anticolon/BedsideClock/bedside_clock_promo.jpg

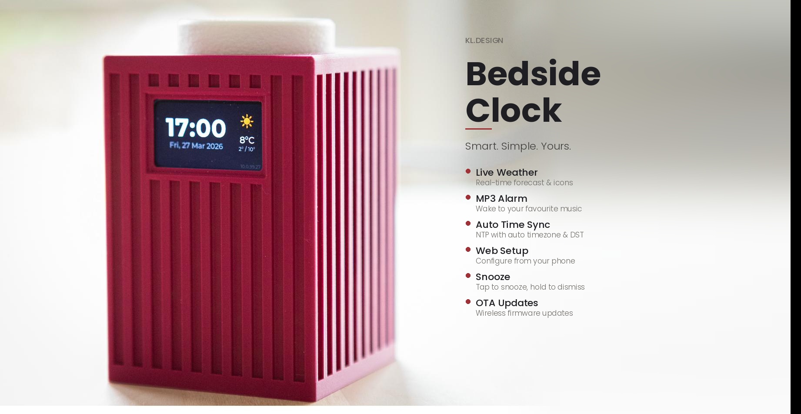
bedside_clock_promo.jpg
