anticolon/BedsideClock/BedsideClock/BedsideClock.ino

/********************************************************************
  Bedside Clock — ESP32-C6 + Waveshare 1.47" LCD (320x172)
  ST7789 + Arduino_GFX + LVGL 8.4.0

  MIT License

  Copyright (c) 2025 KL.Design

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
  Features:
    - Big centered clock on left 3/4, weather on right 1/4
    - Rich Meteocons weather icons + temperature
    - NTP time with auto-timezone from coordinates
    - Open-Meteo weather API (free, no key needed)
    - Day/night icon variants
    - Web-based location setup (country -> city search)
    - Alarm with MP3 playback from SD card (MAX98357 I2S amp)
    - Snooze with configurable duration
    - Rotary encoder menu for on-screen settings
    - MP3 file upload/delete via web interface
    - Inspirational wake-up messages
    - Captive Portal WiFi setup (OPEN AP)
    - OTA firmware update
    - BOOT hold (GPIO9) to force AP mode
    - Web interface enable/disable for security

  REQUIRED FILES (same folder as this .ino):
    - lv_conf.h
    - lv_font_clock_big.c  (generated by LVGL font converter)
    - weather_icons.h
    - icon_*.c files        (generated by LVGL image converter)

  REQUIRED LIBRARIES:
    - ESP8266Audio (for AudioFileSourceSD, AudioGeneratorMP3, AudioOutputI2S)
    - SD

  Pins (factory wired):
    LCD: DC=15, CS=14, SCK=7, MOSI=6, RST=21, BLK=22
    SD:  SCK=7(shared), MOSI=6(shared), MISO=5, CS=4
    I2S: BCLK=2, LRC=3, DIN=1
    Encoder: CLK=18, DT=23, SW=0

  KL.Design

  Third-party assets:

  Meteocons Weather Icons — Copyright (c) Bas Milius
  Licensed under the MIT License
  https://github.com/basmilius/weather-icons

  Montserrat Font — Copyright (c) Julieta Ulanovsky, Sol Matas,
  Juan Pablo del Peral, Jacques Le Bailly
  Licensed under the SIL Open Font License 1.1
  https://scripts.sil.org/OFL
  Used via LVGL built-in fonts and custom clock font generation.
********************************************************************/

#define FW_VERSION "1.2.0"

#include <Arduino.h>
#include <SPI.h>
#include <WiFi.h>
#include <Preferences.h>
#include <HTTPClient.h>
#include <time.h>

#include <AsyncTCP.h>
#include <ESPAsyncWebServer.h>
#include <DNSServer.h>
#include <Update.h>
#include <esp_ota_ops.h>

#include <Arduino_GFX_Library.h>

#define LV_CONF_INCLUDE_SIMPLE
#include <lvgl.h>

// SD card
#include <SD.h>

// Audio (ESP8266Audio library)
#include <AudioFileSourceSD.h>
#include <AudioFileSourceBuffer.h>
#include <AudioGeneratorMP3.h>
#include <AudioOutputI2S.h>

#include "weather_icons.h"

// Custom 64px font for big clock digits
LV_FONT_DECLARE(lv_font_clock_big);

// ==========================================================================
//  In-memory log ring buffer (viewable at /log)
// ==========================================================================
#define LOG_BUF_SIZE 8192
static char logBuffer[LOG_BUF_SIZE];
static size_t logPos = 0;
static bool logWrapped = false;
static portMUX_TYPE logMux = portMUX_INITIALIZER_UNLOCKED;  // logMsg() is called from loop() and AsyncTCP

void logMsg(const char *fmt, ...) __attribute__((format(printf, 1, 2)));  // compiler checks format strings
void logMsg(const char *fmt, ...) {
  char tmp[256];
  va_list args;
  va_start(args, fmt);
  int n = vsnprintf(tmp, sizeof(tmp), fmt, args);
  va_end(args);
  if (n <= 0) return;
  if (n >= (int)sizeof(tmp)) n = sizeof(tmp) - 1;

  // Write to Serial
  Serial.print(tmp);

  // Write to ring buffer
  portENTER_CRITICAL(&logMux);
  for (int i = 0; i < n; i++) {
    logBuffer[logPos] = tmp[i];
    logPos++;
    if (logPos >= LOG_BUF_SIZE) {
      logPos = 0;
      logWrapped = true;
    }
  }
  portEXIT_CRITICAL(&logMux);
}

String getLog() {
  // Snapshot under the lock (no heap work inside the critical section)
  char *snap = (char *)malloc(LOG_BUF_SIZE + 1);
  if (!snap) return String("(out of memory)");
  size_t n = 0;
  portENTER_CRITICAL(&logMux);
  if (logWrapped) {
    memcpy(snap, logBuffer + logPos, LOG_BUF_SIZE - logPos);
    memcpy(snap + (LOG_BUF_SIZE - logPos), logBuffer, logPos);
    n = LOG_BUF_SIZE;
  } else {
    memcpy(snap, logBuffer, logPos);
    n = logPos;
  }
  portEXIT_CRITICAL(&logMux);
  snap[n] = 0;
  String out(snap);
  free(snap);
  return out;
}

void clearLog() {
  portENTER_CRITICAL(&logMux);
  logPos = 0;
  logWrapped = false;
  memset(logBuffer, 0, LOG_BUF_SIZE);
  portEXIT_CRITICAL(&logMux);
}

// ==========================================================================
//  DEFAULTS (used if nothing saved in Preferences)
// ==========================================================================
#define DEFAULT_LAT       59.33
#define DEFAULT_LON       18.07
#define DEFAULT_TZ_NAME   "Europe/Stockholm"
#define NTP_SERVER        "pool.ntp.org"
#define WEATHER_INTERVAL_MS  (15UL * 60 * 1000)  // 15 minutes

// ==========================================================================
//  PINS
// ==========================================================================
#define LCD_DC    15
#define LCD_CS    14
#define LCD_SCK    7
#define LCD_MOSI   6
#define LCD_RST   21
#define LCD_BL    22
#define BOOT_BTN_PIN  9

// SD card (shares SPI bus with LCD)
#define SD_MISO    5
#define SD_CS      4

// I2S audio (MAX98357)
#define I2S_BCLK   2
#define I2S_LRC    3
#define I2S_DOUT   1

// Rotary encoder (EC11) — also used as alarm dismiss (tap) and menu (hold 1s)
#define ENC_CLK    18   // A pin
#define ENC_DT     23   // B pin
#define ENC_SW      0   // Push switch (active LOW)

#define MENU_HOLD_MS  1000   // hold encoder button to enter/exit menu

#define FORCE_PORTAL_HOLD_MS  5000   // matches README; long enough to avoid accidental reboots

// ==========================================================================
//  DISPLAY  (landscape 320×172)
// ==========================================================================
Arduino_DataBus *bus = new Arduino_ESP32SPI(LCD_DC, LCD_CS, LCD_SCK, LCD_MOSI);
Arduino_GFX *gfx = new Arduino_ST7789(
  bus, LCD_RST,
  1,          // rotation = 1 (landscape 320×172)
  true,       // IPS = true (correct color inversion for Waveshare 1.47")
  172, 320,   // native W × H
  34, 0,      // col_offset1, row_offset1
  34, 0       // col_offset2, row_offset2
);

// ==========================================================================
//  LVGL buffers & pointers
// ==========================================================================
static lv_disp_draw_buf_t draw_buf;
static lv_color_t *disp_draw_buf = nullptr;

// Portal UI
static lv_obj_t *label_status   = NULL;
static lv_obj_t *label_ip       = NULL;
static lv_obj_t *boot_bar       = NULL;
static lv_obj_t *boot_bar_label = NULL;

// Clock UI
static lv_obj_t *label_time     = NULL;
static lv_obj_t *label_date     = NULL;
static lv_obj_t *label_temp     = NULL;
static lv_obj_t *label_hilo        = NULL;   // daily high/low
static lv_obj_t *label_alarm    = NULL;   // alarm indicator
static lv_obj_t *weather_icon_img = NULL;

// ==========================================================================
//  WiFi / Web / DNS
// ==========================================================================
Preferences prefs;
AsyncWebServer server(80);
bool webEnabled = true;  // web config interface on/off
DNSServer dnsServer;

bool captivePortalRunning = false;
bool portalForced = false;   // portal opened on purpose (BOOT hold) — never auto-leave it

#define WIFI_CONNECT_TIMEOUT_MS  20000                 // boot-time connect attempt
#define PORTAL_WIFI_RETRY_MS     (2UL * 60 * 1000)     // fallback portal: retry saved WiFi this often
#define WIFI_KEEPALIVE_MS        60000                 // clock mode: reconnect check interval
bool clockMode = false;
String savedSSID, savedPASS, scannedOptionsHTML;

// ==========================================================================
//  SD Card
// ==========================================================================
bool sdCardOk = false;
String mp3Files[32];       // up to 32 MP3 files
int mp3FileCount = 0;

// ==========================================================================
//  Audio
// ==========================================================================
AudioGeneratorMP3 *mp3Player = nullptr;
AudioFileSourceSD *mp3Source = nullptr;
AudioFileSourceBuffer *mp3Buffer = nullptr;
AudioOutputI2S    *audioOut  = nullptr;
bool audioPlaying = false;
bool testPlaying = false;     // test playback (non-alarm)

// Audio command flags — set by async web handlers, acted on by main loop
volatile bool audioReqTestStart = false;
volatile bool audioReqTestStop  = false;
volatile bool audioReqDismiss   = false;
volatile bool audioReqVolume    = false;  // apply volume change from main loop
volatile bool uiReqAlarmLabel   = false;  // request alarm label refresh from main loop
volatile bool uploadInProgress  = false;  // true while receiving file upload chunks
volatile uint32_t uploadLastActivity = 0; // millis() of last upload body callback (idle watchdog)
volatile bool reqRescanMP3      = false;  // request MP3 list rescan from main loop
volatile bool reqLocationApply  = false;  // apply new location (TZ + weather) from main loop

// ==========================================================================
//  Alarm settings (saved in Preferences)
// ==========================================================================
int    alarmHour   = 7;
int    alarmMinute = 0;
bool   alarmEnabled = false;   // armed for next trigger
String alarmSound  = "";       // MP3 filename on SD
int    alarmVolume = 50;       // 0-100 percentage
bool   alarmFiring = false;    // currently ringing
bool   alarmSnoozing = false; // snooze countdown active
unsigned long snoozeEndTime = 0;
int    snoozeDuration = 5;    // snooze minutes (saved in prefs)
time_t lastFiredTarget = 0;   // alarm moment that last rang (or was skipped), so it rings once
String firingSound = "";       // tune picked when the alarm fired (snooze re-rings the same one)
String playingFile = "";       // MP3 currently open (alarm or test)

// Weekly schedule (advanced, opt-in). While on, it replaces the single
// one-shot alarm: each active day rings every week. Index = tm_wday (0 = Sunday).
struct SchedDay { uint8_t on, hour, min; };
bool     schedEnabled = false;
bool     schedStored  = false;   // schedule saved at least once (else seeded from the alarm)
SchedDay sched[7];
String   schedSound[7];          // "" = use the default tune (alarmSound)
time_t   skipTarget = 0;         // scheduled alarm moment the user chose to skip (0 = none)
const char *const dayNames[7] = { "Sun", "Mon", "Tue", "Wed", "Thu", "Fri", "Sat" };

// Alarm wake-up messages (random pick on fire)
const char* alarmMessages[] = {
  "Have a wonderful day!",
  "This day is full of potential!",
  "Dad loves you!",
  "Mom loves you!",
  "You are beautiful!",
  "You make the world brighter!",
  "Today is going to be amazing!",
  "You are so loved!",
  "The world needs your smile!",
  "You are stronger than you know!",
  "Great things await you today!",
  "You are enough, always!",
  "Today is yours to shine!",
  "Be proud of who you are!",
  "Your family believes in you!"
};
#define NUM_ALARM_MESSAGES (sizeof(alarmMessages) / sizeof(alarmMessages[0]))
const char* currentAlarmMsg = alarmMessages[0];

// ==========================================================================
//  Rotary Encoder state (ISR-driven full quadrature decode)
// ==========================================================================
volatile int encDelta = 0;          // accumulated rotation (+/- ticks)
static bool encSwPressed = false;
static bool encSwHandled = false;   // prevent repeat actions
static uint32_t encSwDownTime = 0;
static bool encLongHandled = false; // long-press already acted on

// Full quadrature state table — maps (prevState << 2 | newState) to direction.
// 0 = no move or invalid, +1 = CW, -1 = CCW
static const int8_t encTable[16] = {
   0, -1,  1,  0,
   1,  0,  0, -1,
  -1,  0,  0,  1,
   0,  1, -1,  0
};
static volatile uint8_t encState = 0;  // last 2-bit gray code state

void IRAM_ATTR encoderISR() {
  uint8_t s = encState & 3;  // previous state
  if (digitalRead(ENC_CLK)) s |= 4;
  if (digitalRead(ENC_DT))  s |= 8;
  encState = (s >> 2);       // save new state for next time
  encDelta += encTable[s];
}

// ==========================================================================
//  On-screen Menu state
// ==========================================================================
bool menuActive = false;
int  menuCursor = 0;          // 0=Back, 1=Brightness, 2=AlarmTime, 3=AlarmSound, 4=AlarmArm
bool menuEditing = false;     // currently editing a value
int  menuEditSub = 0;         // sub-field: 0=hour, 1=minute for alarm time

#define MENU_ITEMS 8
const char* menuLabels[] = { "Brightness", "Wake up", "Alarm", "Snooze", "Tune", "Volume", "Test", "Webpage" };

// Menu LVGL objects
static lv_obj_t *menuContainer = NULL;
static lv_obj_t *menuItemLabels[MENU_ITEMS] = {};
static lv_obj_t *menuValueLabels[MENU_ITEMS] = {};

// ==========================================================================
//  Location settings (saved in Preferences)
// ==========================================================================
float  cfgLat = DEFAULT_LAT;
float  cfgLon = DEFAULT_LON;
String cfgTzName = DEFAULT_TZ_NAME;
String cfgCity = "Stockholm";
String cfgCountry = "Sweden";
int    cfgUtcOffset = 3600;    // seconds, fetched from Open-Meteo
int    cfgBrightness = 255;   // 0-255 backlight PWM

// ==========================================================================
//  Weather data
// ==========================================================================
int   weatherCode    = -1;
float weatherTemp    = 0.0;
float weatherTempMin = 0.0;
float weatherTempMax = 0.0;
bool  weatherIsDay   = true;
bool  weatherValid   = false;
unsigned long lastWeatherFetch = 0;

// ==========================================================================
//  WMO Weather Code descriptions
// ==========================================================================
const char* wmoDescription(int code) {
  switch (code) {
    case 0:  return "Clear";
    case 1:  return "Mostly Clear";
    case 2:  return "Partly Cloudy";
    case 3:  return "Overcast";
    case 45: case 48: return "Foggy";
    case 51: case 53: case 55: return "Drizzle";
    case 56: case 57: return "Freezing Drizzle";
    case 61: return "Light Rain";
    case 63: return "Rain";
    case 65: return "Heavy Rain";
    case 66: case 67: return "Freezing Rain";
    case 71: return "Light Snow";
    case 73: return "Snow";
    case 75: return "Heavy Snow";
    case 77: return "Snow Grains";
    case 80: case 81: case 82: return "Showers";
    case 85: case 86: return "Snow Showers";
    case 95: return "Thunderstorm";
    case 96: case 99: return "Thunderstorm+Hail";
    default: return "Unknown";
  }
}

// ==========================================================================
//  Preferences load/save
// ==========================================================================
void loadSavedWiFi() {
  prefs.begin("wifi", true);
  savedSSID = prefs.getString("ssid", "");
  savedPASS = prefs.getString("pass", "");
  prefs.end();
}
void clearWiFiCredentials() {
  prefs.begin("wifi", false);
  prefs.remove("ssid"); prefs.remove("pass");
  prefs.end();
}
// Pages before v1.2.0 had no charset, so browsers posted city names with
// a-umlaut etc. as Windows-1252/Latin-1 bytes. Pages are UTF-8 now: convert once.
// Returns true if s was changed.
bool latin1ToUtf8(String &s) {
  const uint8_t *p = (const uint8_t *)s.c_str();
  bool valid = true;
  for (int i = 0; p[i] && valid; ) {
    int n = p[i] < 0x80 ? 0 : (p[i] & 0xE0) == 0xC0 ? 1 : (p[i] & 0xF0) == 0xE0 ? 2 : (p[i] & 0xF8) == 0xF0 ? 3 : -1;
    if (n < 0 || (n == 1 && p[i] < 0xC2)) { valid = false; break; }
    for (int k = 1; k <= n && valid; k++) if ((p[i + k] & 0xC0) != 0x80) valid = false;  // stops at the NUL
    if (valid) i += n + 1;
  }
  if (valid) return false;
  String out;
  out.reserve(s.length() * 2);
  for (int i = 0; p[i]; i++) {
    if (p[i] < 0x80) out += (char)p[i];
    else { out += (char)(0xC0 | (p[i] >> 6)); out += (char)(0x80 | (p[i] & 0x3F)); }
  }
  s = out;
  return true;
}

void saveLocationSettings();
void loadLocationSettings() {
  prefs.begin("loc", true);
  cfgLat     = prefs.getFloat("lat", DEFAULT_LAT);
  cfgLon     = prefs.getFloat("lon", DEFAULT_LON);
  cfgTzName  = prefs.getString("tz", DEFAULT_TZ_NAME);
  cfgCity    = prefs.getString("city", "Stockholm");
  cfgCountry = prefs.getString("country", "Sweden");
  cfgUtcOffset = prefs.getInt("utcoff", 3600);
  cfgBrightness = prefs.getInt("bright", 255);
  webEnabled = prefs.getBool("webOn", true);
  prefs.end();
  bool fixed = latin1ToUtf8(cfgCity);
  fixed |= latin1ToUtf8(cfgCountry);
  if (fixed) {
    saveLocationSettings();
    logMsg("Location name converted to UTF-8\n");
  }
}
void saveLocationSettings() {
  prefs.begin("loc", false);
  prefs.putFloat("lat", cfgLat);
  prefs.putFloat("lon", cfgLon);
  prefs.putString("tz", cfgTzName);
  prefs.putString("city", cfgCity);
  prefs.putString("country", cfgCountry);
  prefs.putInt("utcoff", cfgUtcOffset);
  prefs.putInt("bright", cfgBrightness);
  prefs.putBool("webOn", webEnabled);
  prefs.end();
}

// ==========================================================================
//  OTA safety net — automatic rollback after a crash loop
// ==========================================================================
// The bootloader has no rollback support, so the app does it itself. Every
// boot caused by a crash or watchdog bumps a counter in NVS; a normal boot, or
// BOOT_HEALTHY_MS of uptime, resets it. After BOOT_CRASH_LIMIT crash boots in a
// row we switch the boot partition to the other OTA slot — the firmware that
// ran before the last OTA update — so a bad update can't brick the clock.
#define BOOT_CRASH_LIMIT  3
#define BOOT_HEALTHY_MS   (90UL * 1000)

void bootGuardCheck()
{
  esp_reset_reason_t why = esp_reset_reason();
  bool crashed = (why == ESP_RST_PANIC || why == ESP_RST_INT_WDT ||
                  why == ESP_RST_TASK_WDT || why == ESP_RST_WDT);
  prefs.begin("boot", false);
  int crashes = crashed ? prefs.getInt("crashes", 0) + 1 : 0;
  prefs.putInt("crashes", crashes);
  prefs.end();

  const esp_partition_t *running = esp_ota_get_running_partition();
  logMsg("Boot: v%s from %s, reset reason %d, crash boots in a row: %d\n",
         FW_VERSION, running ? running->label : "?", (int)why, crashes);
  if (crashes < BOOT_CRASH_LIMIT) return;

  prefs.begin("boot", false);
  prefs.putInt("crashes", 0);
  prefs.end();

  const esp_partition_t *other = esp_ota_get_next_update_partition(NULL);
  esp_app_desc_t desc;
  if (other && other != running &&
      esp_ota_get_partition_description(other, &desc) == ESP_OK &&
      esp_ota_set_boot_partition(other) == ESP_OK) {
    logMsg("Crash loop: rolling back to %s\n", other->label);
    delay(100);
    esp_restart();
  }
  logMsg("Crash loop, but no valid firmware in the other slot\n");
}

// Called from loop(): once we've stayed up long enough, this firmware is good.
void bootGuardMarkHealthy()
{
  static bool done = false;
  if (done || millis() < BOOT_HEALTHY_MS) return;
  done = true;
  prefs.begin("boot", false);
  if (prefs.getInt("crashes", 0) != 0) prefs.putInt("crashes", 0);
  prefs.end();
}

// ==========================================================================
//  Apply timezone from stored settings
// ==========================================================================
void applyTimezone() {
  // Use POSIX TZ string: we set a simple UTC offset.
  // For full DST support we'd need the POSIX TZ rule, but using
  // Open-Meteo's utc_offset_seconds handles DST at fetch time.
  // We re-sync NTP periodically so the offset stays current.
  configTime(cfgUtcOffset, 0, NTP_SERVER);
  logMsg("Timezone applied: UTC%+d (%s)\n", cfgUtcOffset/3600, cfgTzName.c_str());
}

void applyBrightness() {
  analogWrite(LCD_BL, cfgBrightness);
  logMsg("Brightness: %d/255\n", cfgBrightness);
}

// ==========================================================================
//  Alarm preferences
// ==========================================================================
void loadAlarmSettings() {
  prefs.begin("alarm", true);
  alarmHour    = prefs.getInt("hour", 7);
  alarmMinute  = prefs.getInt("min", 0);
  alarmEnabled = prefs.getBool("enabled", false);
  alarmSound   = prefs.getString("sound", "");
  alarmVolume  = prefs.getInt("vol", 50);
  snoozeDuration = prefs.getInt("snooze", 5);
  schedEnabled = prefs.getBool("schedOn", false);
  schedStored  = prefs.getBytes("sched", sched, sizeof(sched)) == sizeof(sched);
  for (int d = 0; d < 7; d++) {
    if (!schedStored || sched[d].hour > 23 || sched[d].min > 59) sched[d] = { 0, (uint8_t)alarmHour, (uint8_t)alarmMinute };
    char key[6]; snprintf(key, sizeof(key), "snd%d", d);
    schedSound[d] = prefs.getString(key, "");
  }
  skipTarget = (time_t)prefs.getLong64("skip", 0);
  prefs.end();
}
void saveAlarmSettings() {
  prefs.begin("alarm", false);
  prefs.putInt("hour", alarmHour);
  prefs.putInt("min", alarmMinute);
  prefs.putBool("enabled", alarmEnabled);
  prefs.putString("sound", alarmSound);
  prefs.putInt("vol", alarmVolume);
  prefs.putInt("snooze", snoozeDuration);
  prefs.end();
}
void saveSchedule() {
  prefs.begin("alarm", false);
  prefs.putBool("schedOn", schedEnabled);
  prefs.putBytes("sched", sched, sizeof(sched));
  for (int d = 0; d < 7; d++) {
    char key[6]; snprintf(key, sizeof(key), "snd%d", d);
    prefs.putString(key, schedSound[d]);
  }
  prefs.putLong64("skip", (int64_t)skipTarget);
  prefs.end();
  schedStored = true;
}

// ==========================================================================
//  SD Card init & MP3 file scanner
// ==========================================================================
void rescanMP3Files() {
  mp3FileCount = 0;
  if (!sdCardOk) return;
  File root = SD.open("/");
  if (root) {
    File f = root.openNextFile();
    while (f && mp3FileCount < 32) {
      String name = String(f.name());
      if (!f.isDirectory() && (name.endsWith(".mp3") || name.endsWith(".MP3"))) {
        if (!name.startsWith("/")) name = "/" + name;
        mp3Files[mp3FileCount++] = name;
      }
      f = root.openNextFile();
    }
    root.close();
  }
  logMsg("Rescan: found %d MP3 files\n", mp3FileCount);

  // If no alarm sound is selected (or selected file was deleted), auto-select the first one
  if (mp3FileCount > 0 && (alarmSound.length() == 0 || !SD.exists(alarmSound.c_str()))) {
    alarmSound = mp3Files[0];
    saveAlarmSettings();
    logMsg("Auto-selected alarm sound: %s\n", alarmSound.c_str());
  }
}

void initSDCard() {
  SPI.begin(LCD_SCK, SD_MISO, LCD_MOSI, SD_CS);
  if (SD.begin(SD_CS)) {
    sdCardOk = true;
    logMsg("SD card mounted\n");
    rescanMP3Files();
  } else {
    sdCardOk = false;
    logMsg("SD card mount failed\n");
  }
}

// ==========================================================================
//  Forward declarations (needed for cross-references in audio/alarm code)
// ==========================================================================
void dismissAlarm();
void updateAlarmLabel();
String htmlAttrEscape(const String &s);

// ==========================================================================
//  Audio playback
// ==========================================================================
#define ALARM_MIN_VOLUME  10   // a ringing alarm is never quieter than this (%)

void applyVolume() {
  int v = alarmVolume;
  if (alarmFiring && v < ALARM_MIN_VOLUME) v = ALARM_MIN_VOLUME;
  if (audioOut) audioOut->SetGain((float)v / 100.0f);
}

// ==========================================================================
//  Fallback alarm tone — used when the MP3 can't be played (no SD card,
//  missing or broken file), so a ringing alarm is never silent.
//  Invariant: I2S is running iff (mp3Player is playing) or toneActive.
//  AudioOutputI2S::begin() asserts if the channel already exists, so the tone
//  only starts after stopAlarmSound() has released the MP3 player.
// ==========================================================================
#define TONE_RATE        16000   // samples/s
#define TONE_HALF_PERIOD 4       // samples → 2 kHz square wave
#define TONE_AMPLITUDE   12000
static bool     toneActive = false;
static uint32_t toneSample = 0;

void stopAlarmSound();

void stopFallbackTone() {
  if (!toneActive) return;
  audioOut->stop();
  toneActive = false;
  applyVolume();
}

void startFallbackTone() {
  if (toneActive || !audioOut) return;
  stopAlarmSound();  // releases any MP3 player (and its I2S channel)
  audioOut->SetChannels(2);
  audioOut->SetRate(TONE_RATE);
  int v = alarmVolume < 30 ? 30 : alarmVolume;
  audioOut->SetGain((float)v / 100.0f);
  if (!audioOut->begin()) return;
  toneActive = true;
  toneSample = 0;
  audioPlaying = true;
  logMsg("Alarm: MP3 unavailable, playing fallback tone\n");
}

// Feed the I2S DMA without blocking: "beep-beep" (120 ms on/off) once a second
void loopFallbackTone() {
  if (!toneActive) return;
  for (int n = 0; n < 1024; n++) {
    uint32_t ms = (toneSample % TONE_RATE) * 1000UL / TONE_RATE;  // position within the 1 s pattern
    bool on = (ms < 120) || (ms >= 240 && ms < 360);
    int16_t v = on ? (((toneSample / TONE_HALF_PERIOD) & 1) ? TONE_AMPLITUDE : -TONE_AMPLITUDE) : 0;
    int16_t smp[2] = { v, v };
    if (!audioOut->ConsumeSample(smp)) break;  // DMA full — continue next loop
    toneSample++;
  }
}

// Alarm MP3 that dies right after starting (corrupt file) → switch to the tone
static uint32_t alarmMp3StartedAt = 0;
static int      alarmMp3QuickEnds = 0;

void initAudio() {
  audioOut = new AudioOutputI2S();
  audioOut->SetPinout(I2S_BCLK, I2S_LRC, I2S_DOUT);
  applyVolume();
}

void startAlarmSound() {
  alarmMp3QuickEnds = 0;
  if (!sdCardOk || firingSound.length() == 0) { startFallbackTone(); return; }
  stopAlarmSound();
  applyVolume();
  playingFile = firingSound;
  mp3Source = new AudioFileSourceSD(playingFile.c_str());
  mp3Buffer = new AudioFileSourceBuffer(mp3Source, 2048);
  mp3Player = new AudioGeneratorMP3();
  if (mp3Player->begin(mp3Buffer, audioOut)) {
    audioPlaying = true;
    alarmMp3StartedAt = millis();
    logMsg("Alarm playing: %s\n", playingFile.c_str());
  } else {
    logMsg("Failed to start MP3\n");
    delete mp3Player; mp3Player = nullptr;
    delete mp3Buffer; mp3Buffer = nullptr;
    delete mp3Source; mp3Source = nullptr;
    startFallbackTone();
  }
}

void stopAlarmSound() {
  if (mp3Player) {
    if (mp3Player->isRunning()) mp3Player->stop();
    delete mp3Player; mp3Player = nullptr;
  }
  if (mp3Buffer) {
    delete mp3Buffer; mp3Buffer = nullptr;
  }
  if (mp3Source) {
    delete mp3Source; mp3Source = nullptr;
  }
  stopFallbackTone();
  audioPlaying = false;
  testPlaying = false;
}

void startTestSound() {
  if (!sdCardOk || alarmSound.length() == 0) return;
  stopAlarmSound();
  applyVolume();
  playingFile = alarmSound;
  mp3Source = new AudioFileSourceSD(playingFile.c_str());
  mp3Buffer = new AudioFileSourceBuffer(mp3Source, 2048);
  mp3Player = new AudioGeneratorMP3();
  if (mp3Player->begin(mp3Buffer, audioOut)) {
    audioPlaying = true;
    testPlaying = true;
    logMsg("Test playing: %s at %d%%\n", alarmSound.c_str(), alarmVolume);
  } else {
    logMsg("Failed to start test MP3\n");
    delete mp3Player; mp3Player = nullptr;
    delete mp3Buffer; mp3Buffer = nullptr;
    delete mp3Source; mp3Source = nullptr;
  }
}

void stopTestSound() {
  stopAlarmSound();
}

void loopAudio() {
  // First, process any commands queued by async web handlers
  if (audioReqTestStop) {
    audioReqTestStop = false;
    stopTestSound();
  }
  if (audioReqDismiss) {
    audioReqDismiss = false;
    dismissAlarm();
  }
  if (audioReqTestStart) {
    audioReqTestStart = false;
    startTestSound();
  }
  if (audioReqVolume) {
    audioReqVolume = false;
    applyVolume();
  }

  loopFallbackTone();

  if (mp3Player && mp3Player->isRunning()) {
    if (!mp3Player->loop()) {
      // MP3 ended — clean up
      mp3Player->stop();
      delete mp3Player; mp3Player = nullptr;
      delete mp3Buffer; mp3Buffer = nullptr;
      delete mp3Source; mp3Source = nullptr;
      if (alarmFiring) {
        // Restart loop for alarm — unless the file keeps ending immediately
        // (corrupt/unreadable), then fall back to the built-in tone
        if (millis() - alarmMp3StartedAt < 1500) alarmMp3QuickEnds++;
        else alarmMp3QuickEnds = 0;
        if (alarmMp3QuickEnds >= 3) {
          audioPlaying = false;
          startFallbackTone();
          return;
        }
        delay(50);  // brief pause before restarting
        mp3Source = new AudioFileSourceSD(playingFile.c_str());
        mp3Buffer = new AudioFileSourceBuffer(mp3Source, 2048);
        mp3Player = new AudioGeneratorMP3();
        if (mp3Player->begin(mp3Buffer, audioOut)) {
          alarmMp3StartedAt = millis();
          logMsg("Alarm MP3 looping...\n");
        } else {
          logMsg("Failed to restart alarm MP3\n");
          delete mp3Player; mp3Player = nullptr;
          delete mp3Buffer; mp3Buffer = nullptr;
          delete mp3Source; mp3Source = nullptr;
          audioPlaying = false;
          startFallbackTone();
        }
      } else {
        // Test or other — just stop
        audioPlaying = false;
        testPlaying = false;
      }
    }
  }
}

// ==========================================================================
//  Alarm check (called every loop iteration in clock mode)
// ==========================================================================
// Fires during the alarm minute, and also catches up if the alarm moment was
// passed since the previous check (loop paused by an upload or a long blocking
// call, or the clock jumped forward, e.g. DST), up to ALARM_CATCHUP_MIN late.
// No catch-up on the first check after boot.
#define ALARM_CATCHUP_MIN 60

// Alarm time for weekday wd (0 = Sunday); false if no alarm that day
bool alarmForDay(int wd, int &h, int &m) {
  if (!schedEnabled) { h = alarmHour; m = alarmMinute; return alarmEnabled; }
  h = sched[wd].hour; m = sched[wd].min;
  return sched[wd].on;
}

// Alarm moment on the date dayOffset days from `now` (negative = past), 0 if none
time_t alarmOnDay(const struct tm &now, int dayOffset, int *wdOut) {
  struct tm t = now;
  t.tm_mday += dayOffset;
  t.tm_hour = 12; t.tm_min = 0; t.tm_sec = 0; t.tm_isdst = -1;
  mktime(&t);  // normalise the date and get its weekday
  int h, m;
  if (!alarmForDay(t.tm_wday, h, m)) return 0;
  t.tm_hour = h; t.tm_min = m; t.tm_isdst = -1;
  if (wdOut) *wdOut = t.tm_wday;
  return mktime(&t);
}

// Next alarm moment after now, 0 if none. withSkipped = false passes over a skipped one.
time_t nextAlarm(bool withSkipped, int *wdOut) {
  struct tm ti;
  if (!getLocalTime(&ti, 0)) return 0;
  time_t now = mktime(&ti);
  for (int d = 0; d <= 7; d++) {
    time_t c = alarmOnDay(ti, d, wdOut);
    if (c > now && (withSkipped || c != skipTarget)) return c;
  }
  return 0;
}

// "Tue 06:30" for the next alarm that will ring, "--:--" if none
void nextAlarmStr(char *buf, int len) {
  int wd = 0;
  time_t t = nextAlarm(false, &wd);
  if (!t) { snprintf(buf, len, "--:--"); return; }
  struct tm lt; localtime_r(&t, &lt);
  snprintf(buf, len, "%s %02d:%02d", dayNames[wd], lt.tm_hour, lt.tm_min);
}

// A skip that no longer matches the next alarm (schedule edited) is dropped
void schedDropStaleSkip() {
  if (skipTarget && (!schedEnabled || nextAlarm(true, nullptr) != skipTarget)) skipTarget = 0;
}

void checkAlarm() {
  static time_t lastCheck = 0;

  struct tm ti;
  if (!getLocalTime(&ti, 0)) return;
  time_t now = mktime(&ti);
  time_t prev = lastCheck ? lastCheck : now;
  lastCheck = now;  // track even while disarmed, so arming never fires retroactively

  // Schedule label names the next alarm: refresh it once a minute (also after NTP sync)
  static time_t lastLabelMin = 0;
  if (schedEnabled && now / 60 != lastLabelMin && !alarmFiring && !alarmSnoozing) {
    lastLabelMin = now / 60;
    updateAlarmLabel();
  }

  if (alarmFiring || alarmSnoozing) return;

  // Most recent alarm moment: today's, or yesterday's (with yesterday's settings)
  int wd = 0;
  time_t target = 0;
  for (int d = 0; d >= -1 && !target; d--) {
    time_t c = alarmOnDay(ti, d, &wd);
    if (c && c <= now) target = c;
  }

  // A skip whose moment passed long ago (clock was off) is dropped
  if (skipTarget && now - skipTarget > ALARM_CATCHUP_MIN * 60) {
    skipTarget = 0;
    saveSchedule();
  }

  if (!target || target == lastFiredTarget) return;
  bool inAlarmMinute = (now - target < 60);
  bool passedSinceLastCheck = (target > prev && now - target <= ALARM_CATCHUP_MIN * 60);
  if (!inAlarmMinute && !passedSinceLastCheck) return;

  lastFiredTarget = target;
  if (schedEnabled && target == skipTarget) {
    skipTarget = 0;
    saveSchedule();
    updateAlarmLabel();
    logMsg("Alarm skipped (%s)\n", dayNames[wd]);
    return;
  }

  // Tune: the day's own song if it still exists, else the default tune
  firingSound = alarmSound;
  if (schedEnabled && schedSound[wd].length() && sdCardOk && SD.exists(schedSound[wd].c_str()))
    firingSound = schedSound[wd];

  alarmFiring = true;
  if (!schedEnabled) {
    alarmEnabled = false;  // one-shot: disable after firing
    saveAlarmSettings();
  }
  currentAlarmMsg = alarmMessages[random(NUM_ALARM_MESSAGES)];
  startAlarmSound();
  updateAlarmLabel();
  logMsg("ALARM TRIGGERED! (%s)\n", schedEnabled ? dayNames[wd] : "single");
}

void dismissAlarm() {
  if (!alarmFiring && !alarmSnoozing) return;
  alarmFiring = false;
  alarmSnoozing = false;
  snoozeEndTime = 0;
  stopAlarmSound();
  updateAlarmLabel();
  logMsg("Alarm dismissed\n");
}

void snoozeAlarm() {
  if (!alarmFiring) return;
  stopAlarmSound();
  alarmFiring = false;
  alarmSnoozing = true;
  snoozeEndTime = millis() + (unsigned long)snoozeDuration * 60UL * 1000UL;
  updateAlarmLabel();
  logMsg("Snoozing for %d minutes\n", snoozeDuration);
}

void checkSnooze() {
  if (!alarmSnoozing) return;
  if ((long)(millis() - snoozeEndTime) >= 0) {  // wrap-safe (millis() rolls over every ~49.7 days)
    // Snooze expired — alarm fires again
    alarmSnoozing = false;
    alarmFiring = true;
    startAlarmSound();
    updateAlarmLabel();
    logMsg("Snooze ended - alarm firing again!\n");
  }
}

void updateAlarmLabel() {
  if (!label_alarm || menuActive) return;  // menuClose() → showClockUI() refreshes it
  if (alarmFiring) {
    lv_label_set_text(label_alarm, currentAlarmMsg);
    lv_obj_set_style_text_color(label_alarm, lv_color_hex(0xFFCC44), 0);
    lv_obj_set_pos(label_alarm, 0, (gfx->height() / 2) + 34);  // quotes shifted up
    lv_obj_clear_flag(label_alarm, LV_OBJ_FLAG_HIDDEN);
  } else if (alarmSnoozing) {
    // Show countdown
    unsigned long remaining = 0;
    long left = (long)(snoozeEndTime - millis());  // wrap-safe
    if (left > 0) remaining = left;
    int secLeft = remaining / 1000;
    int m = secLeft / 60;
    int s = secLeft % 60;
    char buf[24];
    snprintf(buf, sizeof(buf), "Snooze: %d:%02d", m, s);
    lv_label_set_text(label_alarm, buf);
    lv_obj_set_style_text_color(label_alarm, lv_color_hex(0x7CCFFF), 0);
    lv_obj_set_pos(label_alarm, 0, (gfx->height() / 2) + 44);  // original position
    lv_obj_clear_flag(label_alarm, LV_OBJ_FLAG_HIDDEN);
  } else if (schedEnabled ? nextAlarm(false, nullptr) != 0 : alarmEnabled) {
    char buf[24];
    if (schedEnabled) {
      char nb[12]; nextAlarmStr(nb, sizeof(nb));
      snprintf(buf, sizeof(buf), "Alarm: %s", nb);
    } else {
      snprintf(buf, sizeof(buf), "Alarm: %02d:%02d", alarmHour, alarmMinute);
    }
    lv_label_set_text(label_alarm, buf);
    lv_obj_set_style_text_color(label_alarm, lv_color_hex(0xFF3333), 0);
    lv_obj_set_pos(label_alarm, 0, (gfx->height() / 2) + 44);  // original position
    lv_obj_clear_flag(label_alarm, LV_OBJ_FLAG_HIDDEN);
  } else {
    lv_obj_add_flag(label_alarm, LV_OBJ_FLAG_HIDDEN);
  }
}

// ==========================================================================
//  Rotary Encoder reading (rotation via ISR, button polled here)
// ==========================================================================
#define ENC_SW_DEBOUNCE_MS 20

void readEncoder() {
  // Button state (polled — no need for ISR on a slow human press).
  // Debounced: a new level only counts once it has been stable for
  // ENC_SW_DEBOUNCE_MS, so contact bounce can't produce double presses.
  static bool rawLevel = false;
  static uint32_t rawSince = 0;
  bool raw = (digitalRead(ENC_SW) == LOW);
  if (raw != rawLevel) {
    rawLevel = raw;
    rawSince = millis();
  }
  if (millis() - rawSince < ENC_SW_DEBOUNCE_MS) return;

  bool pressed = rawLevel;
  if (pressed && !encSwPressed) {
    encSwDownTime = millis();
    encSwHandled = false;
    encLongHandled = false;
  }
  encSwPressed = pressed;
}

// Consume rotation delta (returns whole detent clicks, resets remainder)
// Full quadrature decode gives 4 state changes per EC11 detent.
// We accumulate and only emit complete detents.
static int encAccum = 0;
#define ENC_COUNTS_PER_DETENT 4

int consumeEncoderDelta() {
  noInterrupts();
  int raw = encDelta;
  encDelta = 0;
  interrupts();
  encAccum += raw;
  int detents = encAccum / ENC_COUNTS_PER_DETENT;
  encAccum %= ENC_COUNTS_PER_DETENT;  // keep remainder
  return detents;
}

// Check for short press (returns true once on release after <1s hold)
bool encoderShortPress() {
  if (!encSwPressed && !encSwHandled && encSwDownTime > 0 && !encLongHandled) {
    encSwHandled = true;
    encSwDownTime = 0;
    return true;
  }
  return false;
}

// Check for long press (returns true once after 1s hold while still pressed)
bool encoderLongPress() {
  if (encSwPressed && !encLongHandled && encSwDownTime > 0) {
    if (millis() - encSwDownTime >= MENU_HOLD_MS) {
      encLongHandled = true;
      return true;
    }
  }
  return false;
}

// ==========================================================================
//  On-screen Menu system
// ==========================================================================
void menuGetValueStr(int item, char *buf, int bufLen) {
  switch (item) {
    case 0: { // Brightness
      int pct = cfgBrightness * 100 / 255;
      snprintf(buf, bufLen, "%d%%", pct);
    } break;
    case 1: // Wake up (schedule: next alarm, read-only)
      if (schedEnabled) nextAlarmStr(buf, bufLen);
      else snprintf(buf, bufLen, "%02d:%02d", alarmHour, alarmMinute);
      break;
    case 2: // Alarm (schedule: skip the next alarm)
      if (schedEnabled) snprintf(buf, bufLen, "%s", skipTarget ? "Skip" : (nextAlarm(true, nullptr) ? "On" : "Off"));
      else snprintf(buf, bufLen, "%s", alarmEnabled ? "On" : "Off");
      break;
    case 3: snprintf(buf, bufLen, "%d min", snoozeDuration); break; // Snooze
    case 4: { // Tune
      if (alarmSound.length() == 0) snprintf(buf, bufLen, "(none)");
      else {
        const char *s = alarmSound.c_str();
        if (s[0] == '/') s++;
        snprintf(buf, bufLen, "%s", s);
      }
    } break;
    case 5: snprintf(buf, bufLen, "%d%%", alarmVolume); break; // Volume
    case 6: snprintf(buf, bufLen, "%s", testPlaying ? "Stop" : "Play"); break; // Test
    case 7: snprintf(buf, bufLen, "%s", webEnabled ? "On" : "Off"); break; // Webpage
  }
}

void hideClockUI() {
  if (label_time) lv_obj_add_flag(label_time, LV_OBJ_FLAG_HIDDEN);
  if (label_date) lv_obj_add_flag(label_date, LV_OBJ_FLAG_HIDDEN);
  if (label_alarm) lv_obj_add_flag(label_alarm, LV_OBJ_FLAG_HIDDEN);
  if (label_temp) lv_obj_add_flag(label_temp, LV_OBJ_FLAG_HIDDEN);
  if (label_hilo) lv_obj_add_flag(label_hilo, LV_OBJ_FLAG_HIDDEN);
  if (weather_icon_img) lv_obj_add_flag(weather_icon_img, LV_OBJ_FLAG_HIDDEN);
  if (label_status) lv_obj_add_flag(label_status, LV_OBJ_FLAG_HIDDEN);
  if (boot_bar) lv_obj_add_flag(boot_bar, LV_OBJ_FLAG_HIDDEN);
  if (boot_bar_label) lv_obj_add_flag(boot_bar_label, LV_OBJ_FLAG_HIDDEN);
}

void showClockUI() {
  if (label_time) lv_obj_clear_flag(label_time, LV_OBJ_FLAG_HIDDEN);
  if (label_date) lv_obj_clear_flag(label_date, LV_OBJ_FLAG_HIDDEN);
  if (label_temp) lv_obj_clear_flag(label_temp, LV_OBJ_FLAG_HIDDEN);
  if (label_hilo) lv_obj_clear_flag(label_hilo, LV_OBJ_FLAG_HIDDEN);
  if (weather_icon_img) lv_obj_clear_flag(weather_icon_img, LV_OBJ_FLAG_HIDDEN);
  if (label_status) lv_obj_clear_flag(label_status, LV_OBJ_FLAG_HIDDEN);
  updateAlarmLabel();  // will show/hide based on alarm state
}

void buildMenuUI() {
  lv_obj_t *scr = lv_scr_act();

  // Hide clock elements so they don't bleed through
  hideClockUI();

  // Full-screen overlay
  menuContainer = lv_obj_create(scr);
  lv_obj_remove_style_all(menuContainer);
  lv_obj_set_size(menuContainer, gfx->width(), gfx->height());
  lv_obj_set_pos(menuContainer, 0, 0);
  lv_obj_set_style_bg_color(menuContainer, lv_color_black(), 0);
  lv_obj_set_style_bg_opa(menuContainer, LV_OPA_COVER, 0);
  lv_obj_clear_flag(menuContainer, LV_OBJ_FLAG_SCROLLABLE);

  // Layout: 6 rows × 22px = 132px, centered vertically in 172px
  int rowH = 20;
  int totalH = MENU_ITEMS * rowH;
  int yStart = (gfx->height() - totalH) / 2 - 8 + 5;
  int leftX = 12;
  int valX = 120;   // value column start (after longest label "Brightness:")
  int valW = gfx->width() - valX - 8;  // ~192px for values

  for (int i = 0; i < MENU_ITEMS; i++) {
    int y = yStart + i * rowH;

    // Label: "Name:"
    menuItemLabels[i] = lv_label_create(menuContainer);
    char lbl[32];
    snprintf(lbl, sizeof(lbl), "  %s:", menuLabels[i]);
    lv_label_set_text(menuItemLabels[i], lbl);
    lv_obj_set_style_text_font(menuItemLabels[i], &lv_font_montserrat_14, 0);
    lv_obj_set_style_text_color(menuItemLabels[i], lv_color_hex(0x888888), 0);
    lv_obj_set_pos(menuItemLabels[i], leftX, y);

    // Value
    menuValueLabels[i] = lv_label_create(menuContainer);
    char vBuf[32]; menuGetValueStr(i, vBuf, sizeof(vBuf));
    lv_label_set_text(menuValueLabels[i], vBuf);
    lv_obj_set_style_text_font(menuValueLabels[i], &lv_font_montserrat_14, 0);
    lv_obj_set_style_text_color(menuValueLabels[i], lv_color_white(), 0);
    lv_obj_set_style_text_align(menuValueLabels[i], LV_TEXT_ALIGN_RIGHT, 0);
    lv_obj_set_width(menuValueLabels[i], valW);
    lv_label_set_long_mode(menuValueLabels[i], LV_LABEL_LONG_DOT);
    lv_obj_set_pos(menuValueLabels[i], valX, y);
  }

  // Hint at bottom
  lv_obj_t *hint = lv_label_create(menuContainer);
  lv_label_set_text(hint, "Hold to exit");
  lv_obj_set_style_text_font(hint, &lv_font_montserrat_10, 0);
  lv_obj_set_style_text_color(hint, lv_color_hex(0x333333), 0);
  lv_obj_align(hint, LV_ALIGN_BOTTOM_MID, 0, -2);

  menuCursor = 0;
  menuEditing = false;
  menuEditSub = 0;
  updateMenuHighlight();
}

void destroyMenuUI() {
  if (menuContainer) {
    lv_obj_del(menuContainer);
    menuContainer = NULL;
  }
  for (int i = 0; i < MENU_ITEMS; i++) {
    menuItemLabels[i] = NULL;
    menuValueLabels[i] = NULL;
  }
}

void updateMenuHighlight() {
  for (int i = 0; i < MENU_ITEMS; i++) {
    if (!menuItemLabels[i]) continue;
    bool selected = (i == menuCursor);
    bool editing = selected && menuEditing;

    // Build label text with cursor indicator
    char lbl[32];
    snprintf(lbl, sizeof(lbl), "%s %s:", selected ? ">" : " ", menuLabels[i]);
    lv_label_set_text(menuItemLabels[i], lbl);

    // Label color: selected = cyan, normal = grey
    lv_obj_set_style_text_color(menuItemLabels[i],
      selected ? lv_color_hex(0x7CCFFF) : lv_color_hex(0x888888), 0);

    // Value color: editing = green, selected = white, normal = grey
    if (editing) {
      lv_obj_set_style_text_color(menuValueLabels[i], lv_color_hex(0x44FF44), 0);
    } else if (selected) {
      lv_obj_set_style_text_color(menuValueLabels[i], lv_color_white(), 0);
    } else {
      lv_obj_set_style_text_color(menuValueLabels[i], lv_color_hex(0x666666), 0);
    }
  }
}

void updateMenuValue(int item) {
  if (!menuValueLabels[item]) return;
  char vBuf[32]; menuGetValueStr(item, vBuf, sizeof(vBuf));
  lv_label_set_text(menuValueLabels[item], vBuf);
}

void menuOpen() {
  if (menuActive) return;
  consumeEncoderDelta();  // drop rotation made on the clock screen
  encAccum = 0;
  menuActive = true;
  buildMenuUI();
  logMsg("Menu opened\n");
}

void menuClose() {
  if (!menuActive) return;
  // Leaving with a long press while editing: keep (and persist) the new value
  if (menuEditing) {
    if (menuCursor == 0) saveLocationSettings();
    if (menuCursor >= 1 && menuCursor <= 5) saveAlarmSettings();
  }
  menuActive = false;
  menuEditing = false;
  if (testPlaying) stopTestSound();
  destroyMenuUI();
  showClockUI();
  logMsg("Menu closed\n");
}

void menuHandleInput() {
  if (!menuActive) return;

  int delta = consumeEncoderDelta();

  if (menuEditing) {
    // Editing mode: rotate changes value, press confirms
    if (delta != 0) {
      switch (menuCursor) {
        case 0: { // Brightness
          cfgBrightness += delta * 15;
          if (cfgBrightness < 5) cfgBrightness = 5;
          if (cfgBrightness > 255) cfgBrightness = 255;
          applyBrightness();
          updateMenuValue(0);
        } break;
        case 1: { // Wake up time
          if (menuEditSub == 0) {
            alarmHour += delta;
            if (alarmHour < 0) alarmHour = 23;
            if (alarmHour > 23) alarmHour = 0;
          } else {
            alarmMinute += delta;
            if (alarmMinute < 0) alarmMinute = 59;
            if (alarmMinute > 59) alarmMinute = 0;
          }
          char tbuf[16];
          if (menuEditSub == 0)
            snprintf(tbuf, sizeof(tbuf), "[%02d]:%02d", alarmHour, alarmMinute);
          else
            snprintf(tbuf, sizeof(tbuf), "%02d:[%02d]", alarmHour, alarmMinute);
          lv_label_set_text(menuValueLabels[1], tbuf);
        } break;
        case 3: { // Snooze duration
          snoozeDuration += delta;
          if (snoozeDuration < 1) snoozeDuration = 1;
          if (snoozeDuration > 30) snoozeDuration = 30;
          updateMenuValue(3);
        } break;
        case 4: { // Tune — cycle through MP3 files
          if (mp3FileCount > 0) {
            int cur = -1;
            for (int i = 0; i < mp3FileCount; i++) {
              if (mp3Files[i] == alarmSound) { cur = i; break; }
            }
            cur += delta;
            if (cur < 0) cur = mp3FileCount - 1;
            if (cur >= mp3FileCount) cur = 0;
            alarmSound = mp3Files[cur];
            updateMenuValue(4);
          }
        } break;
        case 5: { // Volume
          alarmVolume += delta * 5;
          if (alarmVolume < 0) alarmVolume = 0;
          if (alarmVolume > 100) alarmVolume = 100;
          applyVolume();
          updateMenuValue(5);
        } break;
      }
    }

    if (encoderShortPress()) {
      if (menuCursor == 1 && menuEditSub == 0) {
        // Move to minute field
        menuEditSub = 1;
        char tbuf[16];
        snprintf(tbuf, sizeof(tbuf), "%02d:[%02d]", alarmHour, alarmMinute);
        lv_label_set_text(menuValueLabels[1], tbuf);
      } else {
        // Done editing
        menuEditing = false;
        menuEditSub = 0;
        updateMenuValue(menuCursor);
        updateMenuHighlight();
        // Save
        if (menuCursor == 0) saveLocationSettings();
        if (menuCursor >= 1 && menuCursor <= 5) saveAlarmSettings();
      }
    }
  } else {
    // Navigation mode: rotate moves cursor, press enters/acts
    if (delta != 0) {
      menuCursor += delta;
      if (menuCursor < 0) menuCursor = MENU_ITEMS - 1;
      if (menuCursor >= MENU_ITEMS) menuCursor = 0;
      updateMenuHighlight();
    }

    if (encoderShortPress()) {
      switch (menuCursor) {
        case 2: {
          // Alarm: instant toggle, no edit mode. Schedule: skip / unskip the next alarm.
          if (schedEnabled) {
            skipTarget = skipTarget ? 0 : nextAlarm(true, nullptr);
            saveSchedule();
            updateMenuValue(1);
            logMsg("Schedule: %s next alarm\n", skipTarget ? "skip" : "keep");
          } else {
            alarmEnabled = !alarmEnabled;
            saveAlarmSettings();
          }
          updateMenuValue(2);
        } break;
        case 6: {
          // Test: instant toggle test sound
          if (testPlaying) { stopTestSound(); } else { startTestSound(); }
          updateMenuValue(6);
        } break;
        case 7: {
          // Webpage: instant toggle
          webEnabled = !webEnabled;
          updateMenuValue(7);
          saveLocationSettings();
        } break;
        default: {
          if (menuCursor == 1 && schedEnabled) break;  // schedule times are set on the web page
          // Enter edit mode for other items
          menuEditing = true;
          menuEditSub = 0;
          updateMenuHighlight();
          if (menuCursor == 1) {
            char tbuf[16];
            snprintf(tbuf, sizeof(tbuf), "[%02d]:%02d", alarmHour, alarmMinute);
            lv_label_set_text(menuValueLabels[1], tbuf);
          }
        } break;
      }
    }
  }

  // Long press always exits menu
  if (encoderLongPress()) {
    menuClose();
  }
}

// ==========================================================================
//  LVGL Flush
// ==========================================================================
static void my_disp_flush(lv_disp_drv_t *disp, const lv_area_t *area, lv_color_t *color_p)
{
  // Skip display SPI transfer during file upload to avoid SPI bus contention
  // (LCD and SD card share the same SPI bus)
  if (uploadInProgress) {
    lv_disp_flush_ready(disp);
    return;
  }
  uint32_t w = area->x2 - area->x1 + 1;
  uint32_t h = area->y2 - area->y1 + 1;
#if LV_COLOR_16_SWAP
  gfx->draw16bitBeRGBBitmap(area->x1, area->y1, (uint16_t *)&color_p->full, w, h);
#else
  gfx->draw16bitRGBBitmap(area->x1, area->y1, (uint16_t *)&color_p->full, w, h);
#endif
  lv_disp_flush_ready(disp);
}

// ==========================================================================
//  UI helpers
// ==========================================================================
void ui_set_status(const char *txt) {
  if (label_status) lv_label_set_text(label_status, txt);
}
void ui_set_ip(const char *txt) {
  if (label_ip) lv_label_set_text(label_ip, txt);
}
void ui_show_boot_bar(bool show) {
  if (!boot_bar || !boot_bar_label) return;
  if (show) {
    lv_obj_clear_flag(boot_bar, LV_OBJ_FLAG_HIDDEN);
    lv_obj_clear_flag(boot_bar_label, LV_OBJ_FLAG_HIDDEN);
  } else {
    lv_obj_add_flag(boot_bar, LV_OBJ_FLAG_HIDDEN);
    lv_obj_add_flag(boot_bar_label, LV_OBJ_FLAG_HIDDEN);
  }
}
void lv_update() { lv_timer_handler(); }

// ==========================================================================
//  Portal UI build
// ==========================================================================
void build_portal_ui()
{
  uint16_t scrW = gfx->width();
  lv_obj_t *scr = lv_scr_act();

  lv_obj_set_style_bg_color(scr, lv_color_black(), 0);
  lv_obj_set_style_bg_opa(scr, LV_OPA_COVER, 0);
  lv_obj_set_style_border_width(scr, 0, 0);
  lv_obj_set_style_text_color(scr, lv_color_white(), 0);

  lv_obj_t *title = lv_label_create(scr);
  char titleBuf[40];
  snprintf(titleBuf, sizeof(titleBuf), "Bedside Clock v%s", FW_VERSION);
  lv_label_set_text(title, titleBuf);
  lv_obj_set_style_text_font(title, &lv_font_montserrat_20, 0);
  lv_obj_set_style_text_color(title, lv_color_white(), 0);
  lv_obj_align(title, LV_ALIGN_TOP_MID, 0, 8);

  label_status = lv_label_create(scr);
  lv_label_set_text(label_status, "Booting...");
  lv_obj_set_width(label_status, scrW - 20);
  lv_label_set_long_mode(label_status, LV_LABEL_LONG_WRAP);
  lv_obj_set_style_text_font(label_status, &lv_font_montserrat_16, 0);
  lv_obj_set_style_text_align(label_status, LV_TEXT_ALIGN_CENTER, 0);
  lv_obj_set_style_text_color(label_status, lv_color_hex(0x7CCFFF), 0);
  lv_obj_align(label_status, LV_ALIGN_TOP_MID, 0, 40);

  label_ip = lv_label_create(scr);
  lv_label_set_text(label_ip, "");
  lv_obj_set_width(label_ip, scrW - 20);
  lv_label_set_long_mode(label_ip, LV_LABEL_LONG_WRAP);
  lv_obj_set_style_text_font(label_ip, &lv_font_montserrat_16, 0);
  lv_obj_set_style_text_align(label_ip, LV_TEXT_ALIGN_CENTER, 0);
  lv_obj_set_style_text_color(label_ip, lv_color_hex(0xCCCCCC), 0);
  lv_obj_align(label_ip, LV_ALIGN_TOP_MID, 0, 72);

  boot_bar_label = lv_label_create(scr);
  lv_label_set_text(boot_bar_label, "Hold BOOT for Setup Mode");
  lv_obj_set_style_text_font(boot_bar_label, &lv_font_montserrat_14, 0);
  lv_obj_set_style_text_color(boot_bar_label, lv_color_hex(0x888888), 0);
  lv_obj_align(boot_bar_label, LV_ALIGN_BOTTOM_MID, 0, -30);

  boot_bar = lv_bar_create(scr);
  lv_obj_set_size(boot_bar, 160, 16);
  lv_obj_align(boot_bar, LV_ALIGN_BOTTOM_MID, 0, -10);
  lv_bar_set_range(boot_bar, 0, 100);
  lv_bar_set_value(boot_bar, 0, LV_ANIM_OFF);

  ui_show_boot_bar(false);
}

// ==========================================================================
//  Clock UI build  (landscape 320×172)
//  Left 3/4 (~240px): Time + Date CENTERED
//  Right 1/4 (~80px): Weather icon + temp
// ==========================================================================
void build_clock_ui()
{
  lv_obj_t *scr = lv_scr_act();
  lv_obj_clean(scr);

  lv_obj_set_style_bg_color(scr, lv_color_black(), 0);
  lv_obj_set_style_bg_opa(scr, LV_OPA_COVER, 0);
  lv_obj_set_style_border_width(scr, 0, 0);

  uint16_t scrW = gfx->width();   // 320
  uint16_t scrH = gfx->height();  // 172
  int divX = (scrW * 3) / 4;      // ~240
  int rightW = scrW - divX;        // ~80
  int weatherShift = -12;          // shift weather left for balance

  // ---- LEFT 3/4: Time + Date, centered ----
  label_time = lv_label_create(scr);
  lv_label_set_text(label_time, "");  // stays blank until the time is valid (font has digits only)
  lv_obj_set_style_text_font(label_time, &lv_font_clock_big, 0);
  lv_obj_set_style_text_color(label_time, lv_color_white(), 0);
  lv_obj_set_style_text_letter_space(label_time, 2, 0);
  lv_obj_set_style_text_align(label_time, LV_TEXT_ALIGN_CENTER, 0);
  lv_obj_set_width(label_time, divX);
  lv_obj_set_pos(label_time, 0, (scrH / 2) - 44);

  label_date = lv_label_create(scr);
  lv_label_set_text(label_date, "Syncing time...");
  lv_obj_set_style_text_font(label_date, &lv_font_montserrat_20, 0);
  lv_obj_set_style_text_color(label_date, lv_color_hex(0xBBBBBB), 0);
  lv_obj_set_style_text_align(label_date, LV_TEXT_ALIGN_CENTER, 0);
  lv_obj_set_width(label_date, divX);
  lv_obj_set_pos(label_date, 0, (scrH / 2) + 15);

  // Alarm indicator (red, below date)
  label_alarm = lv_label_create(scr);
  lv_label_set_text(label_alarm, "");
  lv_obj_set_style_text_font(label_alarm, &lv_font_montserrat_20, 0);
  lv_obj_set_style_text_color(label_alarm, lv_color_hex(0xFF3333), 0);
  lv_obj_set_style_text_align(label_alarm, LV_TEXT_ALIGN_CENTER, 0);
  lv_obj_set_width(label_alarm, divX);
  lv_obj_set_pos(label_alarm, 0, (scrH / 2) + 44);
  lv_obj_add_flag(label_alarm, LV_OBJ_FLAG_HIDDEN);

  // ---- RIGHT 1/4: Weather (no divider) ----
  int weatherCenterX = divX + rightW / 2 + weatherShift;

  weather_icon_img = lv_img_create(scr);
  lv_img_set_src(weather_icon_img, &icon_unknown);
  lv_obj_set_pos(weather_icon_img, weatherCenterX - WEATHER_ICON_W/2, 12);

  label_temp = lv_label_create(scr);
  lv_label_set_text(label_temp, "--\xC2\xB0""C");
  lv_obj_set_style_text_font(label_temp, &lv_font_montserrat_24, 0);
  lv_obj_set_style_text_color(label_temp, lv_color_white(), 0);
  lv_obj_set_style_text_align(label_temp, LV_TEXT_ALIGN_CENTER, 0);
  lv_obj_set_width(label_temp, rightW);
  lv_obj_set_pos(label_temp, divX + weatherShift, 12 + WEATHER_ICON_H + 4);

  // Daily high/low
  label_hilo = lv_label_create(scr);
  lv_label_set_text(label_hilo, "");
  lv_obj_set_style_text_font(label_hilo, &lv_font_montserrat_14, 0);
  lv_obj_set_style_text_color(label_hilo, lv_color_hex(0xCCCCCC), 0);
  lv_obj_set_style_text_align(label_hilo, LV_TEXT_ALIGN_CENTER, 0);
  lv_obj_set_width(label_hilo, rightW - 2);
  lv_obj_set_pos(label_hilo, divX + weatherShift + 1, 12 + WEATHER_ICON_H + 33);

  // ---- Tiny status at bottom-right ----
  label_status = lv_label_create(scr);
  lv_label_set_text(label_status, "");
  lv_obj_set_style_text_font(label_status, &lv_font_montserrat_12, 0);
  lv_obj_set_style_text_color(label_status, lv_color_hex(0x333333), 0);
  lv_obj_align(label_status, LV_ALIGN_BOTTOM_RIGHT, -14, -2);

  // Boot bar (hidden)
  boot_bar_label = lv_label_create(scr);
  lv_label_set_text(boot_bar_label, "Hold BOOT for Setup");
  lv_obj_set_style_text_color(boot_bar_label, lv_color_hex(0x444444), 0);
  lv_obj_align(boot_bar_label, LV_ALIGN_BOTTOM_LEFT, 4, -20);
  lv_obj_add_flag(boot_bar_label, LV_OBJ_FLAG_HIDDEN);

  boot_bar = lv_bar_create(scr);
  lv_obj_set_size(boot_bar, 120, 10);
  lv_obj_align(boot_bar, LV_ALIGN_BOTTOM_LEFT, 4, -4);
  lv_bar_set_range(boot_bar, 0, 100);
  lv_bar_set_value(boot_bar, 0, LV_ANIM_OFF);
  lv_obj_add_flag(boot_bar, LV_OBJ_FLAG_HIDDEN);
}

// ==========================================================================
//  Update clock display
// ==========================================================================
static char prevTimeStr[6] = "";

void update_clock_display()
{
  struct tm ti;
  if (!getLocalTime(&ti, 0)) return;

  char timeBuf[6];
  snprintf(timeBuf, sizeof(timeBuf), "%02d:%02d", ti.tm_hour, ti.tm_min);

  if (strcmp(timeBuf, prevTimeStr) != 0) {
    lv_label_set_text(label_time, timeBuf);
    strcpy(prevTimeStr, timeBuf);
  }

  static int prevDay = -1;
  if (ti.tm_mday != prevDay) {
    prevDay = ti.tm_mday;
    const char *days[] = {"Sun","Mon","Tue","Wed","Thu","Fri","Sat"};
    const char *mons[] = {"Jan","Feb","Mar","Apr","May","Jun",
                          "Jul","Aug","Sep","Oct","Nov","Dec"};
    char dateBuf[32];
    snprintf(dateBuf, sizeof(dateBuf), "%s, %d %s %d",
             days[ti.tm_wday], ti.tm_mday, mons[ti.tm_mon], 1900 + ti.tm_year);
    lv_label_set_text(label_date, dateBuf);
  }
}

// ==========================================================================
//  Update weather display
// ==========================================================================
void update_weather_display()
{
  if (!weatherValid) return;

  char tempBuf[16];
  snprintf(tempBuf, sizeof(tempBuf), "%.0f\xC2\xB0""C", weatherTemp);
  lv_label_set_text(label_temp, tempBuf);

  // Daily high/low
  if (label_hilo) {
    char hiloBuf[24];
    snprintf(hiloBuf, sizeof(hiloBuf), "%.0f\xC2\xB0 / %.0f\xC2\xB0", weatherTempMax, weatherTempMin);  // high / low
    lv_label_set_text(label_hilo, hiloBuf);
  }

  if (weather_icon_img) {
    const lv_img_dsc_t *icon = get_weather_icon(weatherCode, weatherIsDay);
    lv_img_set_src(weather_icon_img, icon);
  }
}

// ==========================================================================
//  Fetch weather from Open-Meteo  (also gets UTC offset for timezone)
// ==========================================================================
void fetchWeather()
{
  if (WiFi.status() != WL_CONNECTED) return;

  HTTPClient http;
  char url[350];
  snprintf(url, sizeof(url),
    "https://api.open-meteo.com/v1/forecast?"
    "latitude=%.4f&longitude=%.4f"
    "&current=temperature_2m,weather_code,is_day"
    "&daily=temperature_2m_max,temperature_2m_min"
    "&forecast_days=1"
    "&timezone=%s",
    cfgLat, cfgLon, cfgTzName.c_str());

  http.begin(url);
  http.setTimeout(8000);
  int httpCode = http.GET();

  if (httpCode == 200) {
    String payload = http.getString();
    int idx;

    // Find the "current":{...} block — skip past "current_units" which appears first
    int currentBlock = payload.indexOf("\"current\":{");
    if (currentBlock < 0) currentBlock = 0; // fallback

    idx = payload.indexOf("\"temperature_2m\":", currentBlock);
    if (idx >= 0) {
      int start = idx + 17, end = start;
      while (end < (int)payload.length() &&
             (payload[end] == '-' || payload[end] == '.' || isdigit(payload[end]))) end++;
      if (end > start) weatherTemp = payload.substring(start, end).toFloat();
    }

    idx = payload.indexOf("\"weather_code\":", currentBlock);
    if (idx >= 0) {
      int start = idx + 15, end = start;
      while (end < (int)payload.length() && isdigit(payload[end])) end++;
      if (end > start) weatherCode = payload.substring(start, end).toInt();
    }

    idx = payload.indexOf("\"is_day\":", currentBlock);
    if (idx >= 0) {
      weatherIsDay = (payload[idx + 9] == '1');
    }

    // Parse utc_offset_seconds to keep timezone in sync (handles DST)
    idx = payload.indexOf("\"utc_offset_seconds\":");
    if (idx >= 0) {
      int start = idx + 21, end = start;
      if (start < (int)payload.length() && payload[start] == '-') end++;
      while (end < (int)payload.length() && isdigit(payload[end])) end++;
      int newOffset = payload.substring(start, end).toInt();
      bool haveDigits = end > start + (payload[start] == '-' ? 1 : 0);
      if (haveDigits && abs(newOffset) <= 14 * 3600 && newOffset != cfgUtcOffset) {
        cfgUtcOffset = newOffset;
        saveLocationSettings();
        applyTimezone();
      }
    }

    // Parse daily min/max temperatures
    // Daily block: "daily":{"time":[...],"temperature_2m_max":[X],"temperature_2m_min":[Y]}
    int dailyBlock = payload.indexOf("\"daily\":{");
    if (dailyBlock >= 0) {
      idx = payload.indexOf("\"temperature_2m_max\":[", dailyBlock);
      if (idx >= 0) {
        int start = idx + 22, end = start;  // 22 = length of "temperature_2m_max":[
        if (start < (int)payload.length() && payload[start] == '-') end++;
        while (end < (int)payload.length() &&
               (payload[end] == '.' || isdigit(payload[end]))) end++;
        if (end > start) weatherTempMax = payload.substring(start, end).toFloat();
      }
      idx = payload.indexOf("\"temperature_2m_min\":[", dailyBlock);
      if (idx >= 0) {
        int start = idx + 22, end = start;  // 22 = length of "temperature_2m_min":[
        if (start < (int)payload.length() && payload[start] == '-') end++;
        while (end < (int)payload.length() &&
               (payload[end] == '.' || isdigit(payload[end]))) end++;
        if (end > start) weatherTempMin = payload.substring(start, end).toFloat();
      }
    }

    weatherValid = true;
    logMsg("Weather: code=%d, temp=%.1fC, lo=%.1f hi=%.1f, day=%d\n",
                  weatherCode, weatherTemp, weatherTempMin, weatherTempMax, weatherIsDay);
  } else {
    logMsg("Weather HTTP error: %d\n", httpCode);
  }

  http.end();
  lastWeatherFetch = millis();
  // After a failure, retry in about a minute instead of waiting the full interval
  if (httpCode != 200) lastWeatherFetch -= WEATHER_INTERVAL_MS - 60000UL;
}

// ==========================================================================
//  HTML — Shared CSS
// ==========================================================================
const char CSS[] PROGMEM =
  ":root{color-scheme:dark;}"
  "body{font-family:-apple-system,system-ui,Arial,sans-serif;background:#111;color:#eee;margin:0;padding:16px;}"
  ".box{max-width:420px;margin:auto;}"
  "h2{color:#7cf;font-size:22px;margin:8px 0 14px;}h2 small{color:#555;font-size:12px;font-weight:normal;}"
  ".card{background:#1b1b1b;border:1px solid #262626;border-radius:14px;padding:14px;margin:12px 0;}"
  ".card h3{color:#777;font-size:11px;text-transform:uppercase;letter-spacing:1px;margin:0 0 10px;}"
  ".warn{background:#2a1515;border-color:#6b2a22;}"
  "label{display:block;margin:10px 0 4px;font-size:13px;color:#aaa;}"
  "input,select{width:100%;padding:12px;margin:4px 0;border-radius:10px;border:1px solid #333;background:#151515;"
  "color:#fff;font-size:15px;box-sizing:border-box;}"
  "button,.btn{display:block;width:100%;padding:12px;margin-top:10px;border:none;border-radius:10px;background:#2a2a2a;"
  "color:#fff;font-size:15px;font-weight:bold;text-align:center;cursor:pointer;box-sizing:border-box;}"
  "button:disabled{opacity:.5;cursor:default;}"
  ".btnSave{background:#28a745;}.btnClear{background:#c0392b;}.btnBlue{background:#007bff;}"
  ".sm{display:inline-block;width:auto;margin:0;padding:7px 12px;font-size:13px;border-radius:8px;}"
  "a{color:#7cf;text-decoration:none;}"
  ".muted{color:#888;font-size:13px;}"
  ".badge{display:inline-block;background:#12324a;color:#7cf;border-radius:999px;padding:6px 14px;font-size:13px;margin:4px 0 10px;}"
  ".srow{display:flex;align-items:center;justify-content:space-between;gap:12px;}"
  ".srow b{display:block;color:#fff;font-size:15px;}.srow small{display:block;color:#888;font-size:12px;}"
  ".sep{border-top:1px solid #262626;margin:14px -14px;}"
  ".toggle{position:relative;display:inline-block;flex:none;width:52px;height:28px;margin:0;}"
  ".toggle input{opacity:0;width:0;height:0;}"
  ".toggle .slider{position:absolute;cursor:pointer;inset:0;background:#333;border-radius:28px;transition:.3s;}"
  ".toggle .slider:before{content:'';position:absolute;height:22px;width:22px;left:3px;bottom:3px;background:#888;border-radius:50%;transition:.3s;}"
  ".toggle input:checked+.slider{background:#28a745;}"
  ".toggle input:checked+.slider:before{transform:translateX(24px);background:#fff;}"
  ".tp{display:flex;align-items:center;justify-content:center;gap:8px;}"
  ".tp select{width:96px;margin:0;font-size:26px;font-weight:bold;text-align:center;text-align-last:center;transition:color .3s;}"
  ".tp span{color:#fff;font-size:26px;font-weight:bold;}"
  ".menu a{display:flex;justify-content:space-between;padding:13px 2px;border-bottom:1px solid #262626;color:#eee;font-size:15px;}"
  ".menu a:after{content:'\\203A';color:#555;}.menu a:last-child{border:0;}.menu .danger{color:#e74c3c;}"
  ".back{display:block;text-align:center;margin:18px 0;}"
  ".progress{height:8px;background:#333;border-radius:4px;margin:12px 0;overflow:hidden;display:none;}"
  ".progress-bar{height:100%;width:0;background:#007bff;transition:width .2s;}"
  ".status{color:#aaa;font-size:13px;min-height:18px;margin:8px 0;}"
  ".spin{display:none;color:#7cf;margin:8px 0;}";

// Weekly schedule (home page, only sent while the schedule is on)
const char SCHED_CSS[] PROGMEM =
  ".week{display:flex;gap:5px;}"
  ".week span{flex:1;text-align:center;padding:7px 0;border-radius:10px;background:#222;color:#777;font-size:14px;font-weight:bold;"
  "cursor:pointer;border:2px solid transparent;transition:.3s;}"
  ".week span.on{background:#28a745;color:#fff;}"
  ".week span.sel{border-color:#7cf;}"
  ".week small{display:block;font-size:10px;font-weight:normal;margin-top:2px;opacity:.85;}"
  ".day{background:#202020;border:1px solid #2a2a2a;border-left:4px solid #333;border-radius:12px;padding:12px;margin:10px 0 0;transition:border-color .3s,background .3s;}"
  ".day.on{border-left-color:#28a745;background:#1e2620;}"
  ".dh{display:flex;align-items:center;gap:10px;margin-bottom:10px;}"
  ".dh b{flex:1;color:#fff;font-size:16px;}"
  ".day.ok .tp select{color:#7cf;}"
  ".day>select{margin:10px 0 0;font-size:14px;}"
  ".day:not(.on) .tp,.day:not(.on)>select{opacity:.45;}";

// Shared page head: doctype, viewport, title and the common stylesheet.
// The caller adds its own CSS, then PAGE_BODY.
#define PAGE_BODY "</style></head><body><div class='box'>"
String pageHead(const char *title) {
  String h;
  h.reserve(4500);
  h += "<!DOCTYPE html><html><head><meta charset='utf-8'><meta name='viewport' content='width=device-width,initial-scale=1'><title>";
  h += title;
  h += "</title><style>";
  h += FPSTR(CSS);
  return h;
}

// Small one-card message page (saved, rebooting, errors)
String msgPage(const char *title, const char *color, const String &body) {
  String h = pageHead(title);
  h += PAGE_BODY "<div class='card' style='text-align:center;'><h2 style='color:";
  h += color;
  h += ";'>";
  h += title;
  h += "</h2>" + body + "</div></div></body></html>";
  return h;
}

// ==========================================================================
//  HTML — WiFi Config Page
// ==========================================================================
String wifiConfigPage()
{
  String html = pageHead("Bedside Clock");
  html.reserve(5500);
  html += PAGE_BODY "<h2>WiFi Setup</h2>";
  html += "<div class='card'><h3>Network</h3><form method='POST' action='/save'>";
  html += "<label>Select network</label><select name='ssid_select'>" + scannedOptionsHTML + "</select>";
  html += "<label>Or type SSID manually</label><input name='ssid_manual' placeholder='SSID (optional)'>";
  html += "<label>Password</label><input name='pass' type='password' placeholder='WiFi password'>";
  html += "<button class='btnSave' type='submit'>Save &amp; Reboot</button></form>";
  html += "<form method='POST' action='/clear'><button type='submit'>Clear Saved WiFi</button></form></div>";
  html += "<div class='card menu'><a href='/settings'>Location Settings</a><a href='/update'>Firmware Update</a></div>";
  html += "</div></body></html>";
  return html;
}

// ==========================================================================
//  HTML — Location Settings Page
//  Country dropdown is static. City dropdown is populated via JS fetch
//  from Open-Meteo Geocoding API on the client side.
// ==========================================================================
String settingsPage()
{
  String html = pageHead("Location Settings");
  html.reserve(9000);
  html += ".cr{padding:10px 12px;margin:4px 0;border-radius:8px;background:#202020;cursor:pointer;}";
  html += ".cr.sel{background:#12324a;color:#7cf;}";
  html += PAGE_BODY "<h2>Location Settings</h2>";
  html += "<div class='card'><small class='muted'>Current location</small><div style='color:#fff;font-size:17px;font-weight:bold;margin-top:2px;'>";
  html += htmlAttrEscape(cfgCity) + ", " + htmlAttrEscape(cfgCountry);
  html += "</div><small class='muted'>" + String(cfgLat, 2) + ", " + String(cfgLon, 2) + "</small></div>";

  html += "<div class='card'><h3>Change location</h3><form id='locForm'>";
  html += "<label>Country</label>";
  html += "<select id='countrySelect'>";
  html += "<option value=''>-- Select Country --</option>";
  // Common countries first, then a separator, then all
  const char* top[] = {"Sweden","Norway","Denmark","Finland","Germany","United Kingdom",
                       "United States","France","Spain","Italy","Netherlands","Poland",NULL};
  for (int i = 0; top[i]; i++) {
    html += "<option value='";
    html += top[i];
    html += "'";
    if (cfgCountry == top[i]) html += " selected";
    html += ">";
    html += top[i];
    html += "</option>";
  }
  html += "<option disabled>----------</option>";
  const char* more[] = {"Afghanistan","Albania","Algeria","Argentina","Australia","Austria",
    "Bangladesh","Belgium","Brazil","Canada","Chile","China","Colombia","Croatia","Czech Republic",
    "Egypt","Estonia","Ethiopia","Greece","Hungary","Iceland","India","Indonesia","Iran","Iraq",
    "Ireland","Israel","Japan","Kenya","Latvia","Lithuania","Mexico","Morocco","New Zealand",
    "Nigeria","Pakistan","Philippines","Portugal","Romania","Russia","Saudi Arabia","Serbia",
    "Singapore","Slovakia","Slovenia","South Africa","South Korea","Switzerland","Taiwan",
    "Thailand","Turkey","Ukraine","United Arab Emirates","Vietnam",NULL};
  for (int i = 0; more[i]; i++) {
    html += "<option value='";
    html += more[i];
    html += "'>";
    html += more[i];
    html += "</option>";
  }
  html += "</select>";

  html += "<label>Search City</label>";
  html += "<div style='display:flex;gap:6px;'>";
  html += "<input id='cityInput' type='text' placeholder='Type city name...' autocomplete='off' style='flex:1;'>";
  html += "<button type='button' class='btnBlue' onclick='searchCity()' style='width:auto;margin:4px 0;'>Search</button>";
  html += "</div>";
  html += "<p class='spin' id='spinner'>Searching...</p>";
  html += "<div id='results' style='max-height:200px;overflow-y:auto;'></div>";
  html += "<input type='hidden' id='selIdx' value=''>";

  html += "<button type='submit' class='btnSave' style='margin-top:16px;'>Save Location</button>";
  html += "</form></div>";

  // Hidden form for POST
  html += "<form id='saveForm' method='POST' action='/saveLocation' style='display:none;'>";
  html += "<input name='lat' id='hLat'><input name='lon' id='hLon'>";
  html += "<input name='tz' id='hTz'><input name='city' id='hCity'><input name='country' id='hCountry'>";
  html += "</form>";

  html += "<a class='back' href='/'>&#8249; Home</a>";
  html += "</div>";

  // JavaScript
  html += "<script>";
  html += "let cities=[];";
  html += "function esc(t){return String(t).replace(/[&<>\"']/g,function(c){return '&#'+c.charCodeAt(0)+';';});}";

  // Search on Enter key
  html += "document.getElementById('cityInput').addEventListener('keydown',function(e){";
  html += "  if(e.key==='Enter'){e.preventDefault();searchCity();}";
  html += "});";

  // Pick a result
  html += "function pick(i){";
  html += "  document.getElementById('selIdx').value=i;";
  html += "  document.querySelectorAll('.cr').forEach(el=>el.classList.remove('sel'));";
  html += "  document.getElementById('cr'+i).classList.add('sel');";
  html += "}";

  // Search function
  html += "async function searchCity(){";
  html += "  const q=document.getElementById('cityInput').value.trim();";
  html += "  if(q.length<2){alert('Type at least 2 characters');return;}";
  html += "  const res=document.getElementById('results');";
  html += "  const spin=document.getElementById('spinner');";
  html += "  const country=document.getElementById('countrySelect').value;";
  html += "  spin.style.display='block';res.innerHTML='';";
  html += "  document.getElementById('selIdx').value='';";
  html += "  try{";
  html += "    const r=await fetch('https://geocoding-api.open-meteo.com/v1/search?name='+encodeURIComponent(q)+'&count=30&language=en&format=json');";
  html += "    const d=await r.json();";
  html += "    cities=[];";
  html += "    if(d.results){";
  html += "      const seen=new Set();";
  html += "      d.results.forEach(r=>{";
  html += "        if(country&&r.country!==country)return;";
  html += "        const key=r.name+'|'+(r.admin1||'');";
  html += "        if(seen.has(key))return;seen.add(key);";
  html += "        cities.push({name:r.name,lat:r.latitude,lon:r.longitude,tz:r.timezone||'',admin1:r.admin1||'',country:r.country||''});";
  html += "      });";
  html += "    }";
  html += "    if(cities.length===0){";
  html += "      res.innerHTML='<p style=\"color:#888;padding:8px;\">No results'+(country?' in '+country:'')+'</p>';";
  html += "    }else{";
  html += "      let h='';";
  html += "      cities.forEach((c,i)=>{";
  html += "        const label=c.name+(c.admin1?' ('+c.admin1+')':'')+(country?'':' - '+c.country);";
  html += "        h+='<div id=\"cr'+(i+1)+'\" class=\"cr\" onclick=\"pick('+(i+1)+')\">'+esc(label)+'</div>';";
  html += "      });";
  html += "      res.innerHTML=h;";
  html += "    }";
  html += "  }catch(e){res.innerHTML='<p style=\"color:#c00;padding:8px;\">Error searching</p>';}";
  html += "  spin.style.display='none';";
  html += "}";

  // Submit handler
  html += "document.getElementById('locForm').addEventListener('submit',function(e){";
  html += "  e.preventDefault();";
  html += "  const idx=parseInt(document.getElementById('selIdx').value);";
  html += "  if(!idx||idx<1){alert('Please search and select a city first');return;}";
  html += "  const ci=cities[idx-1];";
  html += "  document.getElementById('hLat').value=ci.lat;";
  html += "  document.getElementById('hLon').value=ci.lon;";
  html += "  document.getElementById('hTz').value=ci.tz;";
  html += "  document.getElementById('hCity').value=ci.name;";
  html += "  const c=document.getElementById('countrySelect').value||ci.country;";
  html += "  document.getElementById('hCountry').value=c;";
  html += "  document.getElementById('saveForm').submit();";
  html += "});";
  html += "</script>";

  html += "</body></html>";
  return html;
}

// ==========================================================================
//  HTML — OTA Page
// ==========================================================================
String otaPage()
{
  String html = pageHead("Firmware Update");
  html.reserve(7500);
  html += PAGE_BODY "<h2>Firmware Update</h2>";
  html += "<div class='card'><div class='badge'>Installed: v" FW_VERSION "</div>";
  html += "<label>Firmware file (.app.bin)</label><input type='file' id='fwFile' accept='.bin'>";
  html += "<div class='progress' id='prog'><div class='progress-bar' id='progBar'></div></div>";
  html += "<p class='status' id='status'></p>";
  html += "<button class='btnBlue' id='upBtn' onclick='doOTA()'>Upload Firmware</button></div>";
  html += "<a class='back' href='/'>&#8249; Home</a>";
  html += "</div>";

  html += "<script>";
  html += "function doOTA(){";
  html += "  var f=document.getElementById('fwFile').files[0];";
  html += "  if(!f){alert('Select a .bin file first');return;}";
  html += "  var btn=document.getElementById('upBtn');";
  html += "  var prog=document.getElementById('prog');";
  html += "  var bar=document.getElementById('progBar');";
  html += "  var stat=document.getElementById('status');";
  html += "  btn.disabled=true;btn.textContent='Uploading...';";
  html += "  prog.style.display='block';bar.style.width='0%';";
  html += "  stat.textContent='Uploading firmware...';stat.style.color='#7cf';";
  html += "  var xhr=new XMLHttpRequest();";
  html += "  xhr.open('POST','/doUpdate',true);";
  html += "  xhr.upload.onprogress=function(e){";
  html += "    if(e.lengthComputable){var p=Math.round(e.loaded*100/e.total);bar.style.width=p+'%';}";
  html += "  };";
  html += "  xhr.onload=function(){";
  html += "    if(xhr.status==200&&xhr.responseText==='OK'){";
  html += "      bar.style.width='100%';bar.style.background='#28a745';";
  html += "      stat.textContent='Update complete! Waiting for reboot...';stat.style.color='#28a745';";
  html += "      btn.textContent='Rebooting...';";
  html += "      waitForReboot();";
  html += "    }else{";
  html += "      stat.textContent='Update failed: '+(xhr.responseText||'Unknown error');stat.style.color='#c0392b';";
  html += "      bar.style.background='#c0392b';";
  html += "      btn.disabled=false;btn.textContent='Upload Firmware';";
  html += "    }";
  html += "  };";
  html += "  xhr.onerror=function(){";
  html += "    stat.textContent='Connection lost - device may be rebooting...';stat.style.color='#FFcc44';";
  html += "    btn.textContent='Rebooting...';";
  html += "    waitForReboot();";
  html += "  };";
  html += "  var fd=new FormData();fd.append('update',f);xhr.send(fd);";
  html += "}";

  html += "function waitForReboot(){";
  html += "  var stat=document.getElementById('status');";
  html += "  var dots=0;";
  html += "  var iv=setInterval(()=>{";
  html += "    dots=(dots+1)%4;";
  html += "    stat.textContent='Waiting for reboot'+'.'.repeat(dots);";
  html += "  },500);";
  html += "  var attempts=0;";
  html += "  setTimeout(()=>{";
  html += "    var check=setInterval(()=>{";
  html += "      attempts++;";
  html += "      var c=new AbortController();";
  html += "      var t=setTimeout(()=>c.abort(),3000);";
  html += "      fetch('/ping',{signal:c.signal,cache:'no-store'}).then(r=>{";
  html += "        clearTimeout(t);";
  html += "        if(r.ok){clearInterval(check);clearInterval(iv);window.location.replace('/');}";
  html += "      }).catch(()=>{clearTimeout(t);});";
  html += "      if(attempts>30){clearInterval(check);clearInterval(iv);";
  html += "        stat.textContent='Device not responding. Try refreshing manually.';stat.style.color='#c0392b';}";
  html += "    },3000);";
  html += "  },5000);";
  html += "}";
  html += "</script>";

  html += "</body></html>";
  return html;
}

// ==========================================================================
//  HTML — Clock Mode Home Page (simple dashboard + links)
// ==========================================================================
String clockHomePage()
{
  String html = pageHead("Bedside Clock");
  html.reserve(14000);
  html += ".slider-row{display:flex;align-items:center;gap:12px;margin:12px 0;}";
  html += ".slider-row input[type=range]{flex:1;height:6px;-webkit-appearance:none;background:#333;border-radius:3px;outline:none;}";
  html += ".slider-row input[type=range]::-webkit-slider-thumb{-webkit-appearance:none;width:22px;height:22px;border-radius:50%;background:#7cf;cursor:pointer;}";
  html += ".slider-row span{min-width:40px;text-align:right;color:#fff;font-size:14px;}";
  if (schedEnabled) html += FPSTR(SCHED_CSS);
  html += PAGE_BODY "<h2>Bedside Clock <small>v" FW_VERSION "</small></h2>";
  html += "<div class='card'><small class='muted'>" + htmlAttrEscape(cfgCity) + ", " + htmlAttrEscape(cfgCountry) + "</small>";
  if (weatherValid) {
    char t[16]; snprintf(t, sizeof(t), "%.0f&deg;C", weatherTemp);
    html += "<div style='color:#fff;font-size:20px;font-weight:bold;margin-top:2px;'>" + String(t) + " &middot; " + wmoDescription(weatherCode) + "</div>";
  }
  html += "</div>";

  // Alarm section
  html += "<div class='card'><h3>Alarm</h3>";
  // Weekly schedule (advanced). Day cards are built by the script below to keep the page small.
  html += "<div class='srow'><div><b>Weekly schedule</b><small>Own time and sound for each day</small></div>";
  html += "<label class='toggle'><input type='checkbox' id='schedOn'";
  if (schedEnabled) html += " checked";
  html += "><span class='slider'></span></label></div>";
  html += "<div class='sep'></div>";

  // Single alarm (hidden, not removed, while the schedule is on: the script still binds to it)
  html += "<div id='single'";
  if (schedEnabled) html += " style='display:none;'";
  html += "><div class='srow'><div class='tp'>";
  // Hour select (00-23)
  html += "<select id='alarmH'>";
  for (int h = 0; h < 24; h++) {
    char hh[4]; snprintf(hh, sizeof(hh), "%02d", h);
    html += "<option value='" + String(h) + "'";
    if (h == alarmHour) html += " selected";
    html += ">" + String(hh) + "</option>";
  }
  html += "</select>";
  html += "<span>:</span>";
  // Minute select (00-59)
  html += "<select id='alarmM'>";
  for (int m = 0; m < 60; m++) {
    char mm[4]; snprintf(mm, sizeof(mm), "%02d", m);
    html += "<option value='" + String(m) + "'";
    if (m == alarmMinute) html += " selected";
    html += ">" + String(mm) + "</option>";
  }
  html += "</select></div>";
  html += "<div style='text-align:center;'><label class='toggle'><input type='checkbox' id='alarmOn'";
  if (alarmEnabled) html += " checked";
  html += "><span class='slider'></span></label><div class='muted' id='alarmStatus' style='margin-top:4px;'>";
  html += alarmFiring ? "RINGING" : (alarmSnoozing ? "Snoozing" : (alarmEnabled ? "Armed" : "Off"));
  html += "</div></div></div></div>";

  if (schedEnabled) {
    html += "<div class='badge' id='schedSt'>" + schedStatus() + "</div>";
    html += "<div class='week' id='wk'></div><div class='day' id='pane'></div>";
  }
  html += "</div>";

  // Sound selection
  html += "<div class='card'><h3>Sound</h3>";
  html += schedEnabled ? "<label>Default sound</label>" : "<label>Alarm sound</label>";
  html += "<select id='alarmSound'>";
  if (!sdCardOk) {
    html += "<option value=''>No SD card</option>";
  } else if (mp3FileCount == 0) {
    html += "<option value=''>No MP3 files found</option>";
  } else {
    for (int i = 0; i < mp3FileCount; i++) {
      String esc = htmlAttrEscape(mp3Files[i]);
      html += "<option value='" + esc + "'";
      if (mp3Files[i] == alarmSound) html += " selected";
      html += ">" + esc + "</option>";
    }
  }
  html += "</select>";

  // Volume slider
  html += "<label>Volume</label>";
  html += "<div class='slider-row'>";
  html += "<input type='range' id='volSlider' min='0' max='100' value='" + String(alarmVolume) + "' oninput='volUpdate(this.value)'>";
  html += "<span id='volVal'>" + String(alarmVolume) + "%</span>";
  html += "</div>";

  // Test play/stop button
  html += "<button class='btnBlue' id='testBtn' onclick='toggleTest()'>";
  html += testPlaying ? "Stop Test" : "Play Test";
  html += "</button>";

  if (alarmFiring) {
    html += "<button class='btnClear' onclick=\"fetch('/alarm/dismiss').then(()=>location.reload())\">Dismiss Alarm</button>";
  } else if (alarmSnoozing) {
    html += "<button class='btnClear' onclick=\"fetch('/alarm/dismiss').then(()=>location.reload())\">Cancel Snooze</button>";
  }
  html += "</div>";

  // Brightness slider
  html += "<div class='card'><h3>Display</h3><label>Brightness</label>";
  html += "<div class='slider-row'>";
  html += "<input type='range' id='brSlider' min='5' max='255' value='" + String(cfgBrightness) + "' oninput='brUpdate(this.value)'>";
  html += "<span id='brVal'>" + String((int)(cfgBrightness * 100 / 255)) + "%</span>";
  html += "</div></div>";

  html += "<div class='card menu'>";
  html += "<a href='/files'>Sound Files</a>";
  html += "<a href='/settings'>Location Settings</a>";
  html += "<a href='/update'>Firmware Update</a>";
  html += "<a href='/syslog'>System Log</a>";
  html += "<a href='/factory' class='danger'>Factory Reset</a>";
  html += "</div></div>";

  html += "<script>";
  // Brightness
  html += "let brTimeout=null;";
  html += "function brUpdate(v){";
  html += "  document.getElementById('brVal').textContent=Math.round(v*100/255)+'%';";
  html += "  clearTimeout(brTimeout);";
  html += "  brTimeout=setTimeout(()=>{";
  html += "    fetch('/brightness?v='+v).then(r=>r.text()).then(t=>console.log(t));";
  html += "  },200);";
  html += "}";

  // Volume slider
  html += "let volTimeout=null;";
  html += "function volUpdate(v){";
  html += "  document.getElementById('volVal').textContent=v+'%';";
  html += "  clearTimeout(volTimeout);";
  html += "  volTimeout=setTimeout(()=>{";
  html += "    fetch('/alarm/volume?v='+v).then(r=>r.text());";
  html += "  },200);";
  html += "}";

  // Test play/stop
  html += "let testPoll=null;";
  html += "function updateTestBtn(playing){";
  html += "  document.getElementById('testBtn').textContent=playing?'Stop Test':'Play Test';";
  html += "  if(playing&&!testPoll){";
  html += "    testPoll=setInterval(()=>{";
  html += "      fetch('/alarm/testStatus').then(r=>r.text()).then(r=>{";
  html += "        if(r!=='playing'){updateTestBtn(false);}";
  html += "      }).catch(()=>{});";
  html += "    },2000);";
  html += "  }";
  html += "  if(!playing&&testPoll){clearInterval(testPoll);testPoll=null;}";
  html += "}";
  html += "function toggleTest(){";
  html += "  fetch('/alarm/test').then(r=>r.text()).then(r=>{";
  html += "    updateTestBtn(r==='playing');";
  html += "  });";
  html += "}";

  // Alarm toggle & time change
  html += "document.getElementById('alarmOn').addEventListener('change',function(){saveAlarm();});";
  html += "document.getElementById('alarmH').addEventListener('change',function(){saveAlarm();});";
  html += "document.getElementById('alarmM').addEventListener('change',function(){saveAlarm();});";
  html += "document.getElementById('alarmSound').addEventListener('change',function(){saveAlarm();});";
  html += "function saveAlarm(){";
  html += "  const h=document.getElementById('alarmH').value;";
  html += "  const m=document.getElementById('alarmM').value;";
  html += "  const t=('0'+h).slice(-2)+':'+('0'+m).slice(-2);";
  html += "  const on=document.getElementById('alarmOn').checked?1:0;";
  html += "  const s=document.getElementById('alarmSound').value;";
  html += "  const v=document.getElementById('volSlider').value;";
  html += "  const st=document.getElementById('alarmStatus');";
  html += "  fetch('/alarm/set?time='+encodeURIComponent(t)+'&on='+on+'&sound='+encodeURIComponent(s)+'&vol='+v)";
  html += "    .then(r=>r.text()).then(r=>{st.textContent=on?'Armed':'Off';";
  html += "      fetch('/alarm/testStatus').then(r=>r.text()).then(r=>{updateTestBtn(r==='playing');});";
  html += "    });";
  html += "}";

  // Weekly schedule: toggle reloads the page; rows are [on, hour, min, file index] per tm_wday
  html += "const g=id=>document.getElementById(id);";
  html += "g('schedOn').addEventListener('change',function(){fetch('/alarm/sched?en='+(this.checked?1:0)).then(()=>location.reload());});";
  if (schedEnabled) {
    html += "const SC=[";
    for (int d = 0; d < 7; d++) {
      int idx = -1;
      for (int i = 0; i < mp3FileCount && idx < 0; i++) if (mp3Files[i] == schedSound[d]) idx = i;
      html += "[" + String(sched[d].on) + "," + String(sched[d].hour) + "," + String(sched[d].min) + "," + String(idx) + "],";
    }
    html += "];";
    html += "const DN=['Sunday','Monday','Tuesday','Wednesday','Thursday','Friday','Saturday'],ORD=[1,2,3,4,5,6,0];";
    html += "const p2=n=>('0'+n).slice(-2),SF=[...g('alarmSound').options].map(o=>o.value).filter(v=>v);";
    html += "SC.forEach(c=>{c[3]=c[3]>=0?SF[c[3]]:'';});";
    html += "const snd=v=>'\\u266A '+(v?v.replace(/^\\//,''):'Default sound');";
    html += "let cur=new Date().getDay();";
    html += "function opts(n){let o='';for(let i=0;i<n;i++)o+='<option value='+i+'>'+p2(i)+'</option>';return o;}";
    html += "const pn=g('pane');";
    html += "pn.innerHTML=\"<div class='dh'><b id='pn'></b><label class='toggle'><input type='checkbox' id='pon'><span class='slider'></span></label></div>\"";
    html += "+\"<div class='tp'><select id='eh'>\"+opts(24)+\"</select><span>:</span><select id='em'>\"+opts(60)+\"</select></div>\";";
    html += "const es=g('alarmSound').cloneNode(true);es.id='es';";
    html += "[...es.options].forEach(o=>{if(!o.value)o.remove();else o.text=snd(o.value);});";
    html += "es.insertBefore(new Option(snd(''),''),es.firstChild);pn.appendChild(es);";
    html += "function wk(){g('wk').innerHTML=ORD.map(d=>{const c=SC[d];return \"<span data-d='\"+d+\"' class='\"+(c[0]?'on ':'')+(d==cur?'sel':'')+\"'>\"";
    html += "+DN[d][0]+'<small>'+(c[0]?p2(c[1])+':'+p2(c[2]):'off')+'</small></span>';}).join('');}";
    html += "function sel(d){cur=d;const c=SC[d];g('pn').textContent=DN[d];g('pon').checked=!!c[0];";
    html += "g('eh').value=c[1];g('em').value=c[2];es.value=c[3];pn.classList.toggle('on',!!c[0]);wk();}";
    html += "g('wk').addEventListener('click',e=>{const t=e.target.closest('[data-d]');if(t)sel(+t.dataset.d);});";
    html += "pn.addEventListener('change',()=>{const d=cur,c=SC[d];c[0]=g('pon').checked?1:0;c[1]=+g('eh').value;c[2]=+g('em').value;c[3]=es.value;sel(d);";
    html += "fetch('/alarm/sched?d='+d+'&on='+c[0]+'&time='+p2(c[1])+':'+p2(c[2])+'&sound='+encodeURIComponent(c[3]))";
    html += ".then(r=>r.text()).then(r=>{g('schedSt').textContent=r;pn.classList.add('ok');setTimeout(()=>pn.classList.remove('ok'),700);});});";
    html += "sel(cur);";
  }
  html += "</script>";

  html += "</body></html>";
  return html;
}

// ==========================================================================
//  WiFi Scan
// ==========================================================================
void scanNetworks()
{
  scannedOptionsHTML = "<option value=''>-- Select WiFi --</option>";
  int n = WiFi.scanNetworks(false, true);
  if (n <= 0) {
    scannedOptionsHTML += "<option value=''>No networks found</option>";
    return;
  }
  for (int i = 0; i < n; i++) {
    String ssid = WiFi.SSID(i);
    int rssi = WiFi.RSSI(i);
    String sec = (WiFi.encryptionType(i) == WIFI_AUTH_OPEN) ? "OPEN" : "SEC";
    ssid.replace("\"", "&quot;"); ssid.replace("'", "&#39;");
    ssid.replace("<", "&lt;");    ssid.replace(">", "&gt;");
    scannedOptionsHTML += "<option value=\"" + ssid + "\">" + ssid +
      " (" + rssi + " dBm " + sec + ")</option>";
  }
  WiFi.scanDelete();
}

// ==========================================================================
//  Connect WiFi
// ==========================================================================
bool connectToWiFi(const char *ssid, const char *pass, uint32_t timeoutMs)
{
  WiFi.mode(WIFI_STA);
  WiFi.disconnect(true, true);
  delay(200);
  WiFi.begin(ssid, pass);
  uint32_t start = millis();
  while (WiFi.status() != WL_CONNECTED && millis() - start < timeoutMs) {
    lv_update(); delay(10);
  }
  return (WiFi.status() == WL_CONNECTED);
}

// ==========================================================================
//  OTA Endpoints
// ==========================================================================
// OTA is closed while the Webpage is switched Off in the menu (decision D1).
// Recovery: switch Webpage back On in the menu, or hold BOOT 5 s for the setup
// portal (physical access), which keeps OTA open.
static bool otaAllowed() { return webEnabled || portalForced; }

void setupOTAEndpoints()
{
  server.on("/update", HTTP_GET, [](AsyncWebServerRequest *r) {
    if (!otaAllowed()) { r->send(403, "text/plain", "Web interface disabled"); return; }
    r->send(200, "text/html", otaPage());
  });
  // Unguarded liveness check — the OTA page polls it to detect the reboot
  server.on("/ping", HTTP_GET, [](AsyncWebServerRequest *r) {
    r->send(200, "text/plain", FW_VERSION);
  });
  static bool otaOk = false;
  static String otaErr;
  server.on("/doUpdate", HTTP_POST,
    [](AsyncWebServerRequest *r) {
      if (!otaAllowed()) { r->send(403, "text/plain", "Web interface disabled"); return; }
      if (otaOk) {
        r->send(200, "text/plain", "OK");
        delay(1500);
        ESP.restart();
      } else {
        r->send(500, "text/plain", otaErr.length() ? otaErr : String("No firmware received"));
      }
    },
    [](AsyncWebServerRequest *r, String filename, size_t index, uint8_t *data, size_t len, bool final) {
      if (index == 0) {
        otaOk = false;
        otaErr = "";
        logMsg("OTA start: %s\n", filename.c_str());
        if (Update.isRunning()) Update.abort();  // a previous attempt was interrupted
        if (!otaAllowed()) {
          otaErr = "Web interface disabled";
          logMsg("OTA rejected: web interface disabled\n");
          return;
        }
        // Only accept an ESP32-C6 application image: image magic 0xE9, chip id
        // 0x000D, and the app descriptor magic 0xABCD5432 at offset 0x20.
        // The merged USB .bin starts with the bootloader instead — writing that
        // into an app slot would leave the clock unbootable.
        if (len < 0x24 || data[0] != 0xE9 || data[12] != 0x0D || data[13] != 0x00 ||
            data[0x20] != 0x32 || data[0x21] != 0x54 || data[0x22] != 0xCD || data[0x23] != 0xAB) {
          otaErr = "Not an ESP32-C6 app image (use the app .bin, not the merged one)";
        } else if (!Update.begin(UPDATE_SIZE_UNKNOWN)) {
          otaErr = String("Update begin failed: ") + Update.errorString();
        }
        if (otaErr.length()) logMsg("OTA rejected: %s\n", otaErr.c_str());
      }
      if (otaErr.length()) return;
      if (len && Update.write(data, len) != len) {
        otaErr = String("Write failed: ") + Update.errorString();
        logMsg("OTA %s\n", otaErr.c_str());
        Update.abort();
        return;
      }
      if (final) {
        if (Update.end(true)) {
          otaOk = true;
          logMsg("OTA OK: %u bytes\n", index + len);
        } else {
          otaErr = String("Verify failed: ") + Update.errorString();
          logMsg("OTA %s\n", otaErr.c_str());
        }
      }
    }
  );
}

// ==========================================================================
//  Captive Portal Probes
// ==========================================================================
void setupCaptiveProbeEndpoints()
{
  const char* probes[] = {
    "/generate_204", "/gen_204", "/hotspot-detect.html",
    "/library/test/success.html", "/ncsi.txt", "/connecttest.txt", "/fwlink"
  };
  for (auto &p : probes)
    server.on(p, HTTP_GET, [](AsyncWebServerRequest *r){ r->redirect("/"); });
}

// ==========================================================================
//  File Manager Page
// ==========================================================================
// Escape a string for safe embedding inside an HTML attribute (e.g. onclick="...")
// Handles &, <, >, ", and ' so filenames with special chars don't break the page.
String htmlAttrEscape(const String &s) {
  String out;
  out.reserve(s.length() + 16);
  for (unsigned int i = 0; i < s.length(); i++) {
    char c = s.charAt(i);
    switch (c) {
      case '&':  out += "&amp;";  break;
      case '\'': out += "&#39;";  break;
      case '"':  out += "&quot;"; break;
      case '<':  out += "&lt;";   break;
      case '>':  out += "&gt;";   break;
      default:   out += c;        break;
    }
  }
  return out;
}

String fileManagerPage() {
  String html = pageHead("Sound Files");
  html.reserve(9000);
  html += ".frow{display:flex;align-items:center;gap:8px;padding:10px 0;border-bottom:1px solid #262626;}.frow:last-of-type{border:0;}";
  html += ".fn{flex:1;min-width:0;overflow:hidden;text-overflow:ellipsis;white-space:nowrap;font-size:14px;}";
  html += ".fn.active{color:#fc4;}.fs{color:#888;font-size:12px;white-space:nowrap;}";
  html += ".drop{border:2px dashed #333;border-radius:12px;padding:12px;}";
  html += PAGE_BODY "<h2>Sound Files</h2>";

  // Upload form
  html += "<div class='card'><h3>Upload MP3</h3><div class='drop'>";
  html += "<input type='file' id='fileIn' accept='.mp3'>";
  html += "<div class='progress' id='prog'><div class='progress-bar' id='progBar' style='background:#28a745;'></div></div>";
  html += "<p class='status' id='upStatus'></p>";
  html += "<button class='btnSave' id='upBtn' onclick='doUpload()'>Upload</button>";
  html += "</div></div>";

  // File list
  html += "<div class='card'><h3>On the SD card (" + String(mp3FileCount) + ")</h3>";

  if (!sdCardOk) {
    html += "<p style='color:#e74c3c;'>SD card not available</p>";
  } else if (mp3FileCount == 0) {
    html += "<p class='muted'>No MP3 files found</p>";
  } else {
    for (int i = 0; i < mp3FileCount; i++) {
      String fname = mp3Files[i];

      // Get file size
      File f = SD.open(fname);
      long fsize = f ? f.size() : 0;
      if (f) f.close();
      String sizeStr;
      if (fsize > 1048576) sizeStr = String(fsize / 1048576) + " MB";
      else if (fsize > 1024) sizeStr = String(fsize / 1024) + " KB";
      else sizeStr = String(fsize) + " B";

      bool isActive = (fname == alarmSound);

      String displayName = fname;
      if (displayName.startsWith("/")) displayName = displayName.substring(1);

      String safeName = htmlAttrEscape(displayName);

      html += "<div class='frow'>";
      html += "<span class='fn" + String(isActive ? " active" : "") + "'>" + safeName + "</span>";
      html += "<span class='fs'>" + sizeStr + "</span>";
      // Name goes in data-name (HTML-escaped) - never spliced into a JS string
      html += "<a class='btn sm btnBlue' href='#' data-name='" + safeName + "' onclick='dlFile(this);return false;'>Download</a>";
      html += "<button class='sm btnClear' data-name='" + safeName + "' onclick='delFile(this)'>Delete</button>";
      html += "</div>";
    }
  }

  // SD card info
  if (sdCardOk) {
    uint64_t total = SD.totalBytes();
    uint64_t used = SD.usedBytes();
    html += "<div class='sep'></div><div class='srow'><span class='muted'>" + String((int)(used/1048576)) + " MB used of " + String((int)(total/1048576)) + " MB</span>";
    html += "<button class='sm btnClear' onclick='wipeCard()'>Wipe SD Card</button></div>";
  }
  html += "</div>";

  html += "<a class='back' href='/'>&#8249; Back to Clock</a>";
  html += "</div>";

  // JavaScript
  html += "<script>";
  html += "function doUpload(){";
  html += "  var f=document.getElementById('fileIn').files[0];";
  html += "  if(!f){alert('Select a file first');return;}";
  html += "  if(!f.name.toLowerCase().endsWith('.mp3')){alert('Only .mp3 files');return;}";
  html += "  var btn=document.getElementById('upBtn');";
  html += "  var prog=document.getElementById('prog');";
  html += "  var bar=document.getElementById('progBar');";
  html += "  var stat=document.getElementById('upStatus');";
  html += "  btn.disabled=true;btn.textContent='Uploading...';";
  html += "  prog.style.display='block';bar.style.width='0%';";
  html += "  stat.textContent='';";
  html += "  var CHUNK=32768;";
  html += "  var offset=0;";
  html += "  var total=f.size;";
  html += "  var retries=0;";
  // On final failure, tell the clock to drop the partial file
  html += "  function fail(msg){";
  html += "    stat.textContent=msg;stat.style.color='#c0392b';btn.disabled=false;btn.textContent='Upload';";
  html += "    fetch('/files/upload_abort',{method:'POST'}).catch(function(){});";
  html += "  }";
  html += "  function sendChunk(){";
  html += "    var end=Math.min(offset+CHUNK,total);";
  html += "    var blob=f.slice(offset,end);";
  html += "    var xhr=new XMLHttpRequest();";
  html += "    xhr.open('POST','/files/upload',true);";
  html += "    xhr.timeout=30000;";
  html += "    xhr.setRequestHeader('X-Filename',encodeURIComponent(f.name));";
  html += "    xhr.setRequestHeader('X-Offset',String(offset));";
  html += "    xhr.setRequestHeader('X-Total',String(total));";
  html += "    xhr.setRequestHeader('Content-Type','application/octet-stream');";
  html += "    xhr.onload=function(){";
  html += "      if(xhr.status!=200){";
  // 4xx (bad name, out of sync, too large) won't fix itself — don't retry
  html += "        if(xhr.status>=400&&xhr.status<500){fail('Upload failed: '+xhr.responseText);return;}";
  html += "        retries++;";
  html += "        if(retries<=3){stat.textContent='Retry '+retries+'/3...';stat.style.color='#FFcc44';setTimeout(sendChunk,1000);return;}";
  html += "        fail('Upload failed: '+xhr.responseText);return;";
  html += "      }";
  html += "      retries=0;offset=end;";
  html += "      bar.style.width=Math.round(offset*100/total)+'%';";
  html += "      if(offset>=total){";
  html += "        stat.textContent='Upload complete!';stat.style.color='#27ae60';";
  html += "        setTimeout(function(){location.reload();},500);";
  html += "      }else{sendChunk();}";
  html += "    };";
  html += "    xhr.ontimeout=function(){retries++;if(retries<=3){setTimeout(sendChunk,1000);return;}fail('Timed out');};";
  html += "    xhr.onerror=function(){retries++;if(retries<=3){setTimeout(sendChunk,1000);return;}fail('Upload failed');};";
  html += "    xhr.send(blob);";
  html += "  }";
  html += "  sendChunk();";
  html += "}";

  html += "function dlFile(btn){";
  html += "  var name=btn.dataset.name;";
  html += "  var origText=btn.textContent;";
  html += "  btn.style.pointerEvents='none';btn.style.opacity='0.7';";
  html += "  var xhr=new XMLHttpRequest();";
  html += "  xhr.open('GET','/dl?f='+encodeURIComponent(name),true);";
  html += "  xhr.responseType='blob';";
  html += "  xhr.onprogress=function(e){";
  html += "    if(e.lengthComputable){var p=Math.round(e.loaded*100/e.total);btn.textContent=p+'%';}";
  html += "    else{btn.textContent=Math.round(e.loaded/1024)+'KB';}";
  html += "  };";
  html += "  xhr.onload=function(){";
  html += "    if(xhr.status==200){";
  html += "      var a=document.createElement('a');";
  html += "      a.href=URL.createObjectURL(xhr.response);";
  html += "      a.download=name;a.click();";
  html += "      URL.revokeObjectURL(a.href);";
  html += "    }else{alert('Download failed');}";
  html += "    btn.textContent=origText;btn.style.pointerEvents='';btn.style.opacity='';";
  html += "  };";
  html += "  xhr.onerror=function(){";
  html += "    alert('Download failed');";
  html += "    btn.textContent=origText;btn.style.pointerEvents='';btn.style.opacity='';";
  html += "  };";
  html += "  xhr.send();";
  html += "}";

  html += "function delFile(btn){";
  html += "  var name=btn.dataset.name;";
  html += "  if(!confirm('Delete '+name+'?'))return;";
  html += "  var xhr=new XMLHttpRequest();";
  html += "  xhr.open('POST','/files/delete',true);";
  html += "  xhr.setRequestHeader('Content-Type','application/x-www-form-urlencoded');";
  html += "  xhr.onload=function(){";
  html += "    if(xhr.status==200){location.reload();}";
  html += "    else{alert('Delete failed: '+xhr.responseText);}";
  html += "  };";
  html += "  xhr.onerror=function(){alert('Delete request failed');};";
  html += "  xhr.send('f='+encodeURIComponent(name));";
  html += "}";

  html += "function wipeCard(){";
  html += "  if(!confirm('Delete ALL files from the SD card?'))return;";
  html += "  if(!confirm('Are you sure? This cannot be undone.'))return;";
  html += "  var xhr=new XMLHttpRequest();";
  html += "  xhr.open('POST','/files/wipe',true);";
  html += "  xhr.onload=function(){";
  html += "    if(xhr.status==200){location.reload();}";
  html += "    else{alert('Wipe failed: '+xhr.responseText);}";
  html += "  };";
  html += "  xhr.onerror=function(){alert('Wipe request failed');};";
  html += "  xhr.send();";
  html += "}";
  html += "</script>";

  html += "</body></html>";
  return html;
}

// ==========================================================================
//  Chunked upload state — shared by the /files/upload body handler (AsyncTCP
//  task) and the idle watchdog in loop(). Guarded by uploadMutex.
// ==========================================================================
#define UPLOAD_BUF_SIZE         32768   // max body size of one chunk request
#define UPLOAD_IDLE_TIMEOUT_MS  20000   // abort upload if no data arrives for this long

static SemaphoreHandle_t uploadMutex = nullptr;
static File     uploadFile;
static String   uploadFilename;
static size_t   uploadBytesWritten  = 0;
static size_t   uploadExpectedTotal = 0;
static uint8_t *uploadBuf           = nullptr;  // RAM buffer for one chunk
static size_t   uploadBufPos        = 0;
static bool     uploadChunkSkip     = false;    // chunk was already written (client retry)
static int      uploadStatus        = 200;      // HTTP status for the current chunk request
static const char *uploadStatusMsg  = "OK";
static String   uploadLastDoneName;             // last completed upload (to ack a retried final chunk)
static size_t   uploadLastDoneSize  = 0;

// Close the upload, optionally delete the partial file, free the buffer.
// Caller must hold uploadMutex.
static void uploadCleanupLocked(bool removePartial, const char *reason) {
  if (uploadFile) uploadFile.close();
  uploadFile = File();
  if (removePartial && uploadFilename.length() > 0 && sdCardOk) {
    SD.remove(uploadFilename.c_str());
  }
  if (reason) logMsg("Upload aborted (%s): %s\n", reason, uploadFilename.c_str());
  if (uploadBuf) { free(uploadBuf); uploadBuf = nullptr; }
  uploadBufPos = 0;
  uploadBytesWritten = 0;
  uploadExpectedTotal = 0;
  uploadFilename = "";
  uploadInProgress = false;
}

static void uploadFailLocked(int status, const char *msg, bool abortUpload) {
  uploadStatus = status;
  uploadStatusMsg = msg;
  if (abortUpload && uploadInProgress) uploadCleanupLocked(true, msg);
  else logMsg("Upload: %s\n", msg);
}

// Called from loop(): abort an upload whose client went away.
void uploadIdleWatchdog() {
  if (!uploadInProgress || !uploadMutex) return;
  if (millis() - uploadLastActivity < UPLOAD_IDLE_TIMEOUT_MS) return;
  if (xSemaphoreTake(uploadMutex, 0) != pdTRUE) return;  // body handler busy — try next loop
  if (uploadInProgress && millis() - uploadLastActivity >= UPLOAD_IDLE_TIMEOUT_MS) {
    uploadCleanupLocked(true, "timed out");
    reqRescanMP3 = true;
  }
  xSemaphoreGive(uploadMutex);
}

// URL-decode, strip path/illegal characters, require .mp3. Returns "" if unusable.
static String sanitizeUploadName(const String &raw) {
  String decoded;
  for (unsigned int i = 0; i < raw.length(); i++) {
    if (raw[i] == '%' && i + 2 < raw.length()) {
      char hex[3] = { raw[i+1], raw[i+2], 0 };
      decoded += (char)strtol(hex, NULL, 16);
      i += 2;
    } else {
      decoded += raw[i];
    }
  }
  String out;
  for (unsigned int i = 0; i < decoded.length(); i++) {
    char c = decoded[i];
    if ((uint8_t)c < 0x20 || strchr("/\\:*?\"<>|", c)) continue;
    out += c;
  }
  out.trim();
  while (out.startsWith(".")) out.remove(0, 1);   // no hidden files or ".."
  if (out.length() > 64) {
    // Keep the extension; don't cut in the middle of a UTF-8 sequence
    unsigned int cut = 60;
    while (cut > 0 && ((uint8_t)out[cut] & 0xC0) == 0x80) cut--;
    out = out.substring(0, cut) + out.substring(out.length() - 4);
  }
  String lower = out; lower.toLowerCase();
  if (out.length() <= 4 || !lower.endsWith(".mp3")) return "";
  return out;
}

// ==========================================================================
//  Setup shared web endpoints (settings + OTA) — used in both modes
// ==========================================================================
// "HH:MM" → h, m (false if malformed or out of range)
static bool parseHHMM(const String &t, int &h, int &m) {
  int colon = t.indexOf(':');
  if (colon <= 0) return false;
  h = t.substring(0, colon).toInt();
  m = t.substring(colon + 1).toInt();
  return h >= 0 && h <= 23 && m >= 0 && m <= 59;
}

// Schedule status line for the web page
String schedStatus() {
  char nb[12]; nextAlarmStr(nb, sizeof(nb));
  if (!strcmp(nb, "--:--")) return "No alarm scheduled";
  String st = "Next: " + String(nb);
  if (skipTarget) {
    struct tm lt; localtime_r(&skipTarget, &lt);
    st += " (" + String(dayNames[lt.tm_wday]) + " skipped)";
  }
  return st;
}
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
void loop()
{
  bootGuardMarkHealthy();

  // During file upload, skip ALL display and SD activity to keep SPI bus free
  if (uploadInProgress) {
    uploadIdleWatchdog();  // abort if the client went away, so the clock can't freeze
    delay(1);
    return;
  }

  // Deferred SD rescan requested by async web handlers
  if (reqRescanMP3) {
    reqRescanMP3 = false;
    rescanMP3Files();
  }

  lv_timer_handler();

  if (captivePortalRunning) {
    dnsServer.processNextRequest();
    portalWifiRetry();
  }

  if (clockMode) {
    // Read encoder every loop (must be fast for reliable reading)
    readEncoder();

    // Alarm went off while the menu was open: close it so the next tap snoozes
    if (menuActive && alarmFiring) menuClose();

    // Menu handling
    if (menuActive) {
      menuHandleInput();
      // Don't update clock display while menu is open
    } else {
      update_clock_display();
      consumeEncoderDelta();  // rotation does nothing here — don't let it pile up for the menu

      // Refresh the snooze countdown a few times per second (not every loop)
      static uint32_t lastSnoozeLabel = 0;
      if (alarmSnoozing && millis() - lastSnoozeLabel >= 250) {
        lastSnoozeLabel = millis();
        updateAlarmLabel();
      }

      // Encoder short-press: snooze if ringing, otherwise ignore.
      // Always consume the press — a tap during snooze must not stay latched,
      // or it would instantly re-snooze the alarm when the snooze ends.
      bool shortPress = encoderShortPress();
      if (shortPress && alarmFiring) {
        snoozeAlarm();
      }

      // Encoder long-press: dismiss alarm/snooze if active, open menu if not
      if (encoderLongPress()) {
        if (alarmFiring || alarmSnoozing) {
          dismissAlarm();
        } else {
          menuOpen();
        }
      }
    }

    // Audio processing (always runs — also handles async web commands)
    loopAudio();

    // Handle deferred UI updates from async web handlers
    if (uiReqAlarmLabel) {
      uiReqAlarmLabel = false;
      updateAlarmLabel();
    }

    // New location saved from the web — apply TZ and refresh weather here,
    // not in the AsyncTCP task (blocking HTTPS + LVGL are unsafe there)
    if (reqLocationApply && !alarmFiring && !audioPlaying) {
      reqLocationApply = false;
      applyTimezone();
      fetchWeather();
      update_weather_display();
    }

    clockWifiKeepAlive();

    // Check alarm trigger
    checkAlarm();

    // Check snooze expiry
    checkSnooze();

    // Periodic weather refresh. fetchWeather() blocks for seconds, so never run
    // it while the alarm rings or audio plays (the 2 KB audio buffer would run
    // dry and button presses would be missed) — it runs once playback stops.
    if (!alarmFiring && !audioPlaying && millis() - lastWeatherFetch > WEATHER_INTERVAL_MS) {
      fetchWeather();
      update_weather_display();
    }

    // Check BOOT button for re-entering setup
    static bool bootHeld = false;
    static uint32_t bootStart = 0;
    if (digitalRead(BOOT_BTN_PIN) == LOW) {
      if (!bootHeld) {
        bootHeld = true;
        bootStart = millis();
        ui_show_boot_bar(true);
      }
      uint32_t held = millis() - bootStart;
      int pct = (int)(held * 100UL / FORCE_PORTAL_HOLD_MS);
      lv_bar_set_value(boot_bar, min(pct, 100), LV_ANIM_OFF);

      if (held >= FORCE_PORTAL_HOLD_MS) {
        // Reboot straight into the setup portal (no need to keep holding)
        prefs.begin("boot", false);
        prefs.putBool("portal", true);
        prefs.end();
        ESP.restart();
      }
    } else {
      if (bootHeld) {
        bootHeld = false;
        lv_bar_set_value(boot_bar, 0, LV_ANIM_OFF);
        ui_show_boot_bar(false);
      }
    }
  }

  delay(5);
}
