anticolon/BedsideClock/(commit log)

2026-02-23 Fixed delete function on manage sounds page.
    [BedsideClock.ino]
2026-03-18 Update BedsideClock.ino
    v1.0.2 — Bug fixes & encoder reliability
    Encoder: Switch from polled to interrupt-driven quadrature decode
    Replaced single-edge polled reading with full ISR-based state table decoder
    Fires on every edge of both CLK and DT via attachInterrupt(CHANGE)
    Eliminates missed steps and phantom direction reversals during fast rotation
    Accumulates raw counts and emits whole detent clicks (÷4 for EC11)
    Audio: Fix crashes and playback issues caused by async web server race conditions
    ESPAsyncWebServer callbacks run from the WiFi/TCP task, not the main loop — calling audio functions (stop/start/SetGain) or LVGL updates directly from handlers caused use-after-free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
    [BedsideClock.ino]
2026-03-18 Update BedsideClock.ino to v1.0.3
    v1.0.3 — Web UI fixes, file downloads & OTA improvements
    OTA firmware update page overhaul
    Replaced plain HTML form with JS-based upload showing progress bar and status text during firmware transfer
    After successful upload, page polls device every 3s (with 5s initial delay and 3s timeout per attempt) until it comes back online, then auto-redirects to home page
    Polls /brightness endpoint for lightweight connectivity check
    Failure page now shows a back link
    MP3 file download support
    Added /dl endpoint serving files from SD card via chunked response with heap-allocated File handle (ESPAsyncWebServer's built-in FS serving is unreliable with SD)
    D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
    [BedsideClock.ino]
2026-03-19 version 1.0.4
    v1.0.4: Fix special character filenames, add SD wipe, auto-select alarm sound
    - Add htmlAttrEscape() helper to properly escape filenames containing
    &, ', ", <, > in the file manager web UI. Fixes songs with special
    characters being unplayable and undeletable.
    - Add "Wipe SD Card" button to file manager with double confirmation.
    Removes all files from SD root and clears alarm sound setting.
    - Auto-select first MP3 as alarm sound in rescanMP3Files() when no
    sound is currently set or the selected file no longer exists.
    [BedsideClock.ino]
2026-03-19 Version 1.0.5
    v1.0.5: Fix truncated MP3 uploads caused by SPI bus contention
    - Replace single multipart upload with chunked 8KB sequential uploads.
    The JS client slices files into 8KB blobs and sends them as individual
    POST requests to /files/upload_chunk, with filename, offset, and total
    size in HTTP headers. First chunk creates the file, subsequent chunks
    append. Fixes large MP3 files (4MB+) being truncated to ~500-800KB.
    - Skip LVGL display flush during upload. LCD and SD card share the same
    SPI bus — concurrent display writes were colliding with SD card writes,
    corrupting upload data. Display freezes briefly during upload and
    resumes automatically when complete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
    [BedsideClock.ino]
2026-03-21 Update README.md
    Added wiring diagram
2026-04-02 Update BedsideClock.ino to v1.0.8
    Rewrote upload to close-per-chunk: each 32KB chunk opens, writes, flushes, and closes the file instead of holding a static file handle across 150+ HTTP requests — fixes SPI bus contention with LCD
    Added error propagation from body handler to response handler (HTTP 500 on failure instead of silent 200)
    Server-side write retry (3× with 10ms SPI settle delay) and client-side chunk retry (3× with 1s backoff)
    50ms inter-chunk delay for clean SPI bus window between SD operations
    Added /files/upload_abort endpoint to clean up partial files on failure
    Bumped chunk size from 8KB to 32KB
    [BedsideClock.ino]
2026-04-02 Update BedsideClock.ino v1.0.9
    Added factory reset page (/factory) — wipes all MP3 files, clears WiFi credentials, alarm, location, and brightness settings, reboots into AP setup mode. Double confirmation required, linked in red from home page
    Added system log page (/syslog) — 8KB ring buffer captures upload diagnostics, viewable in-browser with auto-refresh, clear button
    Rewrote upload to RAM-buffered writes: TCP fragments (~974 bytes each) are accumulated into a 32KB buffer and written to SD in a single block per chunk, reducing SD write calls from ~6,600 to ~200 for a 6MB file
    Removed all position() and seek() calls from upload — ESP32 SD library returns -1 for position() on larg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
    [BedsideClock.ino]
2026-10-07 Add OTA safety net: crash-loop rollback and OTA image validation
    - bootGuardCheck(): after 3 consecutive crash/WDT boots without 90 s of
    uptime, switch boot partition back to the previous OTA slot (the
    bootloader has no rollback support)
    - /doUpdate only accepts an ESP32-C6 app image (rejects the merged .bin),
    aborts a stale Update, and reports the real error to the page (M12)
    - FW_VERSION 1.1.0-rc1; Firmware/ota-test/ ignored for test binaries
2026-10-07 Fix high/medium review items: download leak, weather during alarm, menu and input bugs, escaping
    - H2: /dl serves via the library's file response (no leaked SD handles)
    - H4: skip blocking weather fetch while the alarm rings or audio plays
    - M1: long-press exit from the menu keeps and saves the edited value
    - M2: close the menu when the alarm fires so a tap snoozes
    - M3: debounce the encoder push button
    - M4: discard rotation outside the menu
    - M5: wrap-safe snooze timing
    - M6: HTML-escape names in pages; pass filenames via data attributes
    - M10: validate /alarm/set time and sound
    - FW_VERSION 1.1.0-rc2
    Compile-checked; page scripts syntax-checked. Not yet tested on device.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
2026-10-07 Fix remaining medium/low review items and update README (v1.1.0-rc3)
    - M9: catch up a missed alarm minute (<= 60 min) instead of exact match only
    - M11: all SD rescans in the main loop; don't delete/overwrite/wipe the
    file that is playing
    - L1-L9: UTC offset sanity check, weather retry after 60 s, high/low order,
    throttled snooze label, guarded /syslog + new /ping for OTA reboot
    detection, correct web status, 5 s BOOT hold that reboots straight into
    the portal, thread-safe log with all output routed to /syslog,
    "Syncing time..." until NTP is valid
    - L10: README matches the code; v1.1.0 changelog
2026-10-11 Move firmware downloads to GitHub Releases
    Stop tracking Firmware/ (bins are attached to each release instead);
    README flashing steps now link to the latest release.
2026-10-11 Add weekly alarm schedule (v1.2.0-rc1)
    Opt-in advanced mode: each weekday gets its own time, song and active
    switch, set on the web page. Active days ring every week; the menu's
    Alarm item skips the next alarm. Schedule off keeps the v1.1.0 single
    one-shot alarm unchanged.
2026-10-11 Modernise weekly schedule UI (v1.2.0-rc2)
    Day cards with a native time picker, switch and sound select, grouped
    into weekdays and weekend; next-alarm badge and an active-days strip.
    The schedule CSS is only sent while the schedule is on.
2026-10-11 Schedule UI: week overview, tap a day to edit, 24 h only (v1.2.0-rc3)
    Compact day rows show time, sound and switch; tapping a day opens a
    single editor with 00-23 / 00-59 pickers and the sound select. Drops
    <input type=time>, which can show AM/PM in some locales.
2026-10-11 Schedule UI: week strip overview with a single day card (v1.2.0-rc4)
    Drops the per-day list. The strip shows each day's time (or off);
    tapping a day shows its switch, 24 h pickers and sound below it.
2026-10-11 Fix city names saved by older pages; schedule switch first (v1.2.0-rc7)
    Pages before rc6 had no charset, so browsers posted names like
    Bjarred-with-umlaut as Latin-1, which shows as U+FFFD now that pages
    are UTF-8. Convert non-UTF-8 city/country from Latin-1 on load (saved
    back once) and on save. The Weekly schedule switch now sits above the
    single alarm in the Alarm card.
